FaderOrg/fader25_pcb/README.md

# fader25_pcb
Repository for the Fader2.5 Altium database
