FaderOrg/fader25_pcb/Project Outputs for fader2_pcb/Report Board Stack/fader2_blind_vias_pcb.xls

Board Stack Report
Stack Up |  | Layer Stack
Layer | Board Layer Stack | Name | Material | Thickness | Constant
1 |  | Top Paste
2 |  | Top Overlay
3 |  | Top Solder | Solder Resist | 0.40mil | 3.5
4 |  | TOP | Copper | 1.40mil
5 |  | Dielectric 1 | FR-4 | 10.00mil | 4.2
6 |  | L2 | Copper | 1.42mil
7 |  | Dielectric 8 |  | 5.00mil | 4.2
8 |  | L3 | Copper | 1.42mil
9 |  | Dielectric 6 |  | 10.00mil | 4.2
10 |  | L4 | Copper | 1.42mil
11 |  | Dielectric 7 |  | 5.00mil | 4.2
12 |  | L5 | Copper | 1.42mil
13 |  | Dielectric 2 |  | 10.00mil | 4.2
14 |  | BOT | Copper | 1.40mil
15 |  | Bottom Solder | Solder Resist | 0.40mil | 3.5
16 |  | Bottom Overlay
17 |  | Bottom Paste
 | Height : 49.27mil
