FaderOrg/fader25_pcb/Project Outputs for fader2_pcb/BOM/Bill of Materials-fader2_pcb.xlsx

Comment | Description | Designator | Digikey ID | Footprint | LibRef | Manufacturer | Manufacturer ID | Quantity | Layer
TC1.5-52TG2+ | Balun | BL2 |  | AT224-3 | TC1.5-52TG2+ | Mini-Circuits | TC1.5-52TG2+ | 1 | Top
3.3uF |  | C1, C4, C13, C14, C18, C19, C25, C29, C32, C34, C46, C48, C52, C64, C65, C66, C70, C78, C86, C99, C105, C113, C115 | 445-13819-1-ND | 0402 | cap 3p3uF | TDK | C1005X5R1A335K050BC | 23 | Top, Top, Top, Top, Top, Bottom, Top, Top, Top, Bottom, Top, Bottom, Bottom, Top, Top, Top, Top, Top, Bottom, Bottom, Top, Top, Bottom
1uF |  | C2, C23, C31, C33, C37, C38, C40, C90, C92, C95, C104, C114 | 1276-1447-1-ND | 0402 | cap 1uF 0402 | Samsung Electro-Mechanics | CL05A105MO5NNNC | 12 | Top
100nF |  | C3, C17, C26, C47, C63, C69, C71, C75, C77 | 1276-1001-1-ND | 0402 | cap 100nF | Samsung Electro-Mechanics | CL05B104KO5NNNC | 9 | Top, Bottom, Top, Top, Top, Top, Top, Top, Top
10nF |  | C5, C21, C36, C39, C43, C50, C62, C84, C85, C88, C91, C96, C98, C102, C117 | 490-4762-1-ND | 0402 | cap 10nF | Murata | GCM155R71H103KA55D | 15 | Bottom, Bottom, Bottom, Top, Top, Bottom, Top, Top, Top, Bottom, Top, Top, Bottom, Top, Bottom
100pF |  | C6, C22, C51, C89, C100, C103, C118 | 490-6113-1-ND | 0201 | cap 100pF | Murata | GRM0335C1H101JA01D | 7 | Bottom
22uF |  | C8, C10, C67 | 490-4524-1-ND | 1210 | cap 22uF | Murata | GRM32ER71C226KE18L | 3 | Top
1uF |  | C11, C12 | 490-1543-1-ND | 0603 | cap 1uF 0603 | Murata | GRM188R61A105KA61D | 2 | Top
220nF |  | C20, C30, C35, C49, C53, C87, C116 | 1276-1176-1-ND | 0402 | cap 220nF | Samsung Electro-Mechanics | CL05B224KO5NNNC | 7 | Bottom
680pF |  | C76 | 490-14330-1-ND | 0201 | cap 680pF | Murata | GRM0335C1E681JA01D | 1 | Top
Header_3 |  | EN_DVDD, EN_GATE_LINK, EN_VDD_IO, EN_VDD_LINK, EN_VDDA, H5, H7, H16, H18, H19 | 609-3461-ND | HDR1X3 | Header_3 | FCI | 68000-103HLF | 10 | Top
Ferrite Bead |  | FB1, FB3, FB4, FB5, FB7, FB10 | 732-1592-1-ND | 0603 | Ferrite Bead | Wurth | 742792641 | 6 | Top, Top, Top, Bottom, Top, Top
Header 6X2 | Header, 6-Pin, Dual row | H9 | 609-3237-ND | HDR2X6 | Header 6X2 | Amphenol FCI | 67997-212HLF | 1 | Top
Header_2 |  | H13, H15, H17, H20, H25, H_DVDD, H_GATE_LINK, H_VDD_IO, H_VDD_LINK, H_VDDA | 609-3469-ND | HDR1X2 | Header_2 | FCI | 68001-202HLF | 10 | Top
Header 10X2 | Header, 10-Pin, Dual row | P1 | 609-3239-ND | HDR2X10 | Header 10X2 | Amphenol FCI | 67997-220HLF | 1 | Top
1.5Kohm |  | R1, R72 | P1.5KDBCT-ND | 0603 | res 1.5 Kohm | Panasonic | ERA-3AEB152V | 2 | Top
4.32Kohm |  | R2 | P4.32KDBCT-ND | 0603 | res 4.32 Kohm | Panasonic | ERA-3AEB4321V | 1 | Top
930ohm |  | R3 | 311-2391-1-ND | 0603 | res 930 ohm | Yageo | RT0603DRD07931RL | 1 | Top
0.11ohm |  | R4, R24, R38, R39, R41 | RL16R.11FCT-ND | 1206 | res 0.11 ohm | Susumu | RL1632R-R110-F | 5 | Top
3Kohm |  | R5 | P3.0KDBCT-ND | 0603 | res 3 Kohm | Panasonic | ERA-3AEB302V | 1 | Top
2.67Kohm |  | R6, R40 | P2.67KDBCT-ND | 0603 | res 2.67 Kohm | Panasonic | ERA-3AEB2671V | 2 | Top
3.48Kohm |  | R8 | P3.48KDBCT-ND | 0603 | res 3.5 Kohm | Panasonic | ERA-3AEB3481V | 1 | Top
0ohm |  | R9, R30, R52 | P0.0GCT-ND | 0603 | res 0 ohm 0603 | Panasonic | ERJ-3GEY0R00V | 3 | Top
10kohm |  | R11, R12, R13, R14, R15, R16, R17, R18, R19, R20 | P10KDBCT-ND | 0603 | res 10 Kohm | Panasonic | ERA-3AEB103V | 10 | Top
1kohm |  | R21, R22, R23, R31, R32, R33 | P1.00KHCT-ND | 0603 | res 1 Kohm | Panasonic | ERJ-3EKF1001V | 6 | Top
13Kohm |  | R36 | P13KDBCT-ND | 0603 | res 13 Kohm | Panasonic | ERA-3AEB133V | 1 | Top
50ohm |  | R44 | P49.9ABCT-ND | 0201 | res 50 ohm | Panasonic | ERJ-1GEF49R9C | 1 | Top
20Kohm |  | R46, R47 | P20.0KLCT-ND | 0402 | res 20 Kohm | Panasonic | ERJ-2RKF2002X | 2 | Top
300ohm |  | R73 | P300DBCT-ND | 0603 | res 300 ohm | Panasonic | ERA-3AEB301V | 1 | Top
SMA low freq | Johnson SMA | SMA_ANA_N, SMA_ANA_P | WM5543-ND | THRU_SMA_JOHNSON | SMA_JOHNSON | Molex | 0733910060 | 2 | Top
SMA high freq |  | SMA_ANT_0_N, SMA_ANT_0_P, SMA_ANT_1_N, SMA_ANT_1_P, SMA_ANT_2_N, SMA_ANT_2_P, SMA_ANT_3_N, SMA_ANT_3_P, SMA_LINK_RX_N, SMA_LINK_RX_P, SMA_LINK_TX_N, SMA_LINK_TX_P, SMA_LO_N, SMA_LO_P, SMA_LOAD, SMA_OPEN, SMA_SHORT, SMA_THRU_LINK0, SMA_THRU_LINK1, SMA_THRU_RF0, SMA_THRU_RF1 | ACX1962-ND | THRU_SMD_SMA | SMA_THRU_SMD | Amphenol | 132134-15 | 21 | Top
SMA mid freq | Johnson SMA With Cutout | SMA_DIG_CLK | WM5543-ND | THRU_SMA_JOHNSON_CUTOUT | SMA_JOHNSON_CUTOUT | Molex | 0733910060 | 1 | Top
 |  | TP_ANA_N, TP_ANA_P, TP_DVDD, TP_GATE_LINK, TP_VDD_BUFFER, TP_VDD_IO, TP_VDD_LINK, TP_VDDA |  | Test_Point | Test_Point |  |  | 8 | Top
TPS74201 | Variable Voltage Regulator | U1, U3, U12, U16, U21 | 296-19890-1-ND | TPS74201 | TPS74201 | TI | TPS74201RGWR | 5 | Top
 |  | U2 |  | FADER2 | FADER2 |  |  | 1 | Top
AD5254 | Digital Pot | U2, U22 | AD5254BRUZ1-ND | AD5254 | AD5254 | Analog Devices | AD5254BRUZ1 | 2 | Top
NLSV4T244DTR2G | Logic Translator | U4, U7 | NLSV4T244DTR2GOSCT-ND | 948G-01 | NLSV4T244 | ON Semiconductor | NLSV4T244DTR2G | 2 | Top
PCA9517 | I2C Repeater | U5, U6 | 296-24730-1-ND | PCA9517 | PCA9517 | TI | PCA9517DGKR | 2 | Top
MAX9612 | OpAmp ADC | U8, U9, U10, U32 | MAX9612AUB+-ND | MAX9612 | MAX9612 | Maxim | MAX9612AUB+ | 4 | Top
LTC6417 | Single Channel, Low Noise, High Linearity Differential Buffer / 16-Bit ADC Driver with Fast Clamp, 1600 MHz Typical GBW, 10000 V/us Typical SR, 4.75 to 5.25 V, 20-Pin QFN (UDC20), Commercial, Pb-Free | U19 | LTC6417CUDC#PBF-ND | LT-UDC-20_N | LTC6417CUDC#PBF | Linear Technology | LTC6417CUDC#PBF | 1 | Top
TPS79650 | Single Output High PSRR LDO, 1 A, Fixed 5 V Output, 2.7 to 5.5 V Input, 8-pin SON (DRB), -40 to 125 degC, Green (RoHS & no Sb/Br) | U20 | 296-21352-1-ND | TI-DRB8-2400X1650TP_V | TPS79650DRBR | Texas Instruments | TPS79650DRBR | 1 | Top
