FaderOrg/fader25_pcb/Files_for_TestPlan_TestReports/FADER2_bumps.xlsx

Sheet: Full
 | name
 | type= | NC,POW,GND,analog,digital,open-drain,remove=to be removed
 | direction= | input,output,inout
 | match | string
 | termination | 50,40, CMOS
 | side | the side of the layout where the corresponding io cell will be placed. Only the cells with the sides defined will be placed.Area for the non IO ring cells
 | location | [int,int]
 | cell= | name of the IO library cell used forthis particular io. Bump for bump
 |  |  |  |  |  |  |  |  |  |  |  |  |  |  |  |  |  |  |  |  |  |  |  |  |  | Pad Pitch | 0.17
NC;remove;;;;; | VSS;GND;;;;;;bump | ANT_0_P;analog;inout;;;area;;bump | ANT_0_N;analog;inout;;;area;;bump | VSS;GND;;;;;;bump | VSS;GND;;;;;;bump | LO_OVERRIDE_P;analog;inout;;;bottom;;bump | LO_OVERRIDE_N;analog;inout;;;bottom;;bump | VSS;GND;;;;;;bump | RESET;digital;input;;;top;;DIGITAL_IO_OBFUSCATED | SERDES_SUPPLY_PROBE_0;analog;output;;;;;bump | VSS;GND;;;;;;bump | LINK_BM_TX_0_P;analog;output;;;;;bump | LINK_BM_TX_0_N;analog;output;;;;;bump | VSS;GND;;;;;;bump | LINK_BM_RX_0_P;analog;input;;;;;bump | LINK_BM_RX_0_N;analog;input;;;;;bump | VSS;GND;;;;;;bump | VSS;GND;;;;;;bump | IREF_ANALOG;analog;input;;;;;bump | VSS;GND;;;;;;bump | VSS;GND;;;;;;bump | ANT_1_P;analog;inout;;;area;;bump | ANT_1_N;analog;inout;;;area;;bump | VSS;GND;;;;;;bump | NC;remove;;;;; | Col | 26
VSS;GND;;;;;;bump | NC;remove;;;;; | VDD_IO;POW;;;;;;bump | VDD_IO;POW;;;;;;bump | VDD_IO;POW;;;;;;bump | DVDD;POW;;;;;;bump | DVDD;POW;;;;;;bump | DVDD;POW;;;;;;bump | DVDD;POW;;;;;;bump | VSS;GND;;;;;;bump | VSS;GND;;;;;;bump | VSS;GND;;;;;;bump | VSS;GND;;;;;;bump | VDD_BM0;POW;;;;;;bump | VDD_BM0;POW;;;;;;bump | VSS;GND;;;;;;bump | VSS;GND;;;;;;bump | VSS;GND;;;;;;bump | VSS;GND;;;;;;bump | VSS;GND;;;;;;bump | VSS;GND;;;;;;bump | VDD_IO;POW;;;;;;bump | VDD_IO;POW;;;;;;bump | VDD_IO;POW;;;;;;bump | VDD_IO;POW;;;;;;bump | VSS;GND;;;;;;bump | Row | 26
SCAN_IN;digital;input;;;left;;DIGITAL_IO_OBFUSCATED | VDD_IO;POW;;;;;;bump | VDD_IO;POW;;;;;;bump | VDD_IO;POW;;;;;;bump | VDD_IO;POW;;;;;;bump | DVDD;POW;;;;;;bump | DVDD;POW;;;;;;bump | DVDD;POW;;;;;;bump | DVDD;POW;;;;;;bump | VSS;GND;;;;;;bump | VSS;GND;;;;;;bump | VSS;GND;;;;;;bump | VSS;GND;;;;;;bump | VDD_BM0;POW;;;;;;bump | VDD_BM0;POW;;;;;;bump | VSS;GND;;;;;;bump | VSS;GND;;;;;;bump | VSS;GND;;;;;;bump | VSS;GND;;;;;;bump | VSS;GND;;;;;;bump | VSS;GND;;;;;;bump | VDD_IO;POW;;;;;;bump | VDD_IO;POW;;;;;;bump | VDD_IO;POW;;;;;;bump | VDD_IO;POW;;;;;;bump | VSS;GND;;;;;;bump
SCAN_EN;digital;input;;;left;;DIGITAL_IO_OBFUSCATED | VSS;GND;;;;;;bump | VSS;GND;;;;;;bump | VSS;GND;;;;;;bump | VSS;GND;;;;;;bump | VSS;GND;;;;;;bump | VSS;GND;;;;;;bump | VSS;GND;;;;;;bump | VSS;GND;;;;;;bump | VSS;GND;;;;;;bump | VSS;GND;;;;;;bump | VSS;GND;;;;;;bump | VSS;GND;;;;;;bump | Inductor;remove;;;;;; | Inductor;remove;;;;;; | Inductor;remove;;;;;; | VSS;GND;;;;;;bump | VSS;GND;;;;;;bump | VSS;GND;;;;;;bump | VSS;GND;;;;;;bump | VSS;GND;;;;;;bump | VSS;GND;;;;;;bump | VSS;GND;;;;;;bump | VSS;GND;;;;;;bump | VSS;GND;;;;;;bump | VSS;GND;;;;;;bump | height | 4.59
SCAN_CLK;digital;input;;;left;;DIGITAL_IO_OBFUSCATED | VSS;GND;;;;;;bump | VSS;GND;;;;;;bump | VSS;GND;;;;;;bump | VSS;GND;;;;;;bump | VSS;GND;;;;;;bump | VSS;GND;;;;;;bump | VSS;GND;;;;;;bump | VSS;GND;;;;;;bump | VSS;GND;;;;;;bump | VSS;GND;;;;;;bump | VSS;GND;;;;;;bump | VSS;GND;;;;;;bump | VDD_BM0;POW;;;;;;bump | VDD_BM0;POW;;;;;;bump | VSS;GND;;;;;;bump | VSS;GND;;;;;;bump | VSS;GND;;;;;;bump | VSS;GND;;;;;;bump | VSS;GND;;;;;;bump | VSS;GND;;;;;;bump | VSS;GND;;;;;;bump | VSS;GND;;;;;;bump | VSS;GND;;;;;;bump | VSS;GND;;;;;;bump | VSS;GND;;;;;;bump | width | 4.59
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
REF_LO_P;analog;input;;;;;bump | VDD_IO;POW;;;;;;bump | VDD_IO;POW;;;;;;bump | VDD_IO;POW;;;;;;bump | VDD_IO;POW;;;;;;bump | VSS;GND;;;;;;bump | VSS;GND;;;;;;bump | VSS;GND;;;;;;bump | VSS;GND;;;;;;bump | VSS;GND;;;;;;bump | VSS;GND;;;;;;bump | VSS;GND;;;;;;bump | VSS;GND;;;;;;bump | VSS;GND;;;;;;bump | VDD_BM2;POW;;;;;;bump | VDD_BM2;POW;;;;;;bump | VSS;GND;;;;;;bump | VSS;GND;;;;;;bump | VSS;GND;;;;;;bump | VSS;GND;;;;;;bump | VSS;GND;;;;;;bump | VDD_IO;POW;;;;;;bump | VDD_IO;POW;;;;;;bump | VDD_IO;POW;;;;;;bump | VDD_IO;POW;;;;;;bump | REF_DIG_P;analog;input;;;;;bump
VSS;GND;;;;;;bump | VDD_IO;POW;;;;;;bump | VDD_IO;POW;;;;;;bump | VDD_IO;POW;;;;;;bump | VDD_IO;POW;;;;;;bump | VSS;GND;;;;;;bump | VSS;GND;;;;;;bump | VSS;GND;;;;;;bump | VSS;GND;;;;;;bump | VSS;GND;;;;;;bump | VSS;GND;;;;;;bump | VSS;GND;;;;;;bump | VSS;GND;;;;;;bump | VSS;GND;;;;;;bump | VDD_BM2;POW;;;;;;bump | VDD_BM2;POW;;;;;;bump | VSS;GND;;;;;;bump | VSS;GND;;;;;;bump | VSS;GND;;;;;;bump | VSS;GND;;;;;;bump | VSS;GND;;;;;;bump | VDD_IO;POW;;;;;;bump | VDD_IO;POW;;;;;;bump | VDD_IO;POW;;;;;;bump | VDD_IO;POW;;;;;;bump | VSS;GND;;;;;;bump
NC;remove;;;;; | VSS;GND;;;;;;bump | ANT_3_P;analog;inout;;;area;;bump | ANT_3_N;analog;inout;;;area;;bump | VSS;GND;;;;;;bump | VSS;GND;;;;;;bump | ANA_MUX_P;analog;input;;;bottom;;bump | ANA_MUX_N;analog;input;;;bottom;;bump | VSS;GND;;;;;;bump | VSS;GND;;;;;;bump | SERDES_SUPPLY_PROBE_2;analog;output;;;;;bump | VSS;GND;;;;;;bump | LINK_BM_RX_2_P;analog;input;;;;;bump | LINK_BM_RX_2_N;analog;input;;;;;bump | VSS;GND;;;;;;bump | LINK_BM_TX_2_P;analog;output;;;;;bump | LINK_BM_TX_2_N;analog;output;;;;;bump | VSS;GND;;;;;;bump | VSS;GND;;;;;;bump | CLK_DIG_OVERRIDE_P;analog;input;;;;;bump | CLK_DIG_OVERRIDE_N;analog;input;;;;;bump | VSS;GND;;;;;;bump | ANT_2_P;analog;inout;;;area;;bump | ANT_2_N;analog;inout;;;area;;bump | VSS;GND;;;;;;bump | NC;remove;;;;;
 |  |  |  |  |  |  |  |  |  | VDD;POW;;;;;;bump | VDD;POW;;;;;;bump | VDD;POW;;;;;;bump | VDD;POW;;;;;;bump
 |  |  |  |  |  |  |  |  |  | VDD;POW;;;;;;bump | VDD;POW;;;;;;bump | VDD;POW;;;;;;bump | VDD;POW;;;;;;bump
 |  |  |  |  |  |  |  |  |  | VSS;GND;;;;;;bump | VSS;GND;;;;;;bump | VSS;GND;;;;;;bump | VSS;GND;;;;;;bump
 |  |  |  |  |  |  |  |  |  | VSS;GND;;;;;;bump | VSS;GND;;;;;;bump | VSS;GND;;;;;;bump | VSS;GND;;;;;;bump

Sheet: Visual
 |  |  |  |  |  |  |  |  |  |  |  |  |  |  |  |  |  |  |  |  |  |  |  |  |  | Pad Pitch | 0.17
NC | VSS | ANT_0_P | ANT_0_N | VSS | VSS | LO_OVERRIDE_P | LO_OVERRIDE_N | VSS | RESET | SERDES_SUPPLY_PROBE_0 | VSS | LINK_BM_TX_0_P | LINK_BM_TX_0_N | VSS | LINK_BM_RX_0_P | LINK_BM_RX_0_N | VSS | VSS | IREF_ANALOG | VSS | VSS | ANT_1_P | ANT_1_N | VSS | NC | Col | 26
VSS | NC | VDD_IO | VDD_IO | VDD_IO | DVDD | DVDD | DVDD | DVDD | VSS | VSS | VSS | VSS | VDD_BM0 | VDD_BM0 | VSS | VSS | VSS | VSS | VSS | VSS | VDD_IO | VDD_IO | VDD_IO | VDD_IO | VSS | Row | 26
SCAN_IN | VDD_IO | VDD_IO | VDD_IO | VDD_IO | DVDD | DVDD | DVDD | DVDD | VSS | VSS | VSS | VSS | VDD_BM0 | VDD_BM0 | VSS | VSS | VSS | VSS | VSS | VSS | VDD_IO | VDD_IO | VDD_IO | VDD_IO | VSS
SCAN_EN | VSS | VSS | VSS | VSS | VSS | VSS | VSS | VSS | VSS | VSS | VSS | VSS | Inductor | Inductor | Inductor | VSS | VSS | VSS | VSS | VSS | VSS | VSS | VSS | VSS | VSS | height | 4.59
SCAN_CLK | VSS | VSS | VSS | VSS | VSS | VSS | VSS | VSS | VSS | VSS | VSS | VSS | VDD_BM0 | VDD_BM0 | VSS | VSS | VSS | VSS | VSS | VSS | VSS | VSS | VSS | VSS | VSS | width | 4.59
SCAN_OUT | VSS | VSS | VSS | VSS | VSS | VSS | VSS | VSS | DVDD | DVDD | DVDD | DVDD | VDD_BM0 | VDD_BM0 | VSS | VSS | VSS | VSS | VSS | VSS | VSS | VSS | VSS | VSS | VSS
VSS | VSS | VSS | VSS | VSS | VSS | VSS | VSS | VSS | DVDD | DVDD | DVDD | DVDD | Inductor | Inductor | Inductor | VSS | VSS | VSS | VSS | VSS | VSS | Inductor | Inductor | Inductor | VSS
LINK_BM_RX_3_P | VDD_BM3 | VDD_BM3 | VSS | VSS | VSS | VSS | DVDD | DVDD | DVDD | DVDD | VSS | VSS | VSS | VSS | DVDD | DVDD | DVDD | DVDD | VSS | VSS | VSS | VSS | VDD_BM1 | VDD_BM1 | LINK_BM_TX_1_P | VSS | 373
LINK_BM_RX_3_N | VDD_BM3 | VDD_BM3 | VSS | VSS | VSS | VSS | DVDD | DVDD | DVDD | DVDD | VSS | VSS | VSS | VSS | DVDD | DVDD | DVDD | DVDD | VSS | VSS | VSS | VSS | VDD_BM1 | VDD_BM1 | LINK_BM_TX_1_N | DVDD | 94
VSS | Inductor | Inductor | Inductor | VSS | VSS | VSS | VSS | VSS | VDDA | VDDA | VDDA | VDDA | VSS | VSS | VSS | VSS | VSS | VSS | VSS | VSS | VSS | Inductor | Inductor | Inductor | VSS | VDD_LINK* | 16
LINK_BM_TX_3_P | VDD_BM3 | VDD_BM3 | VSS | VSS | VSS | VSS | VSS | VSS | VDDA | VDDA | VDDA | VDDA | VSS | VSS | VSS | VSS | VSS | VSS | VSS | VSS | VSS | VSS | VDD_BM1 | VDD_BM1 | LINK_BM_RX_1_P | VDD_BM* | 32
LINK_BM_TX_3_N | VDD_BM3 | VDD_BM3 | VSS | VSS | VSS | VSS | VSS | VSS | VSS | VSS | VSS | VSS | VDDA | VDDA | VDDA | VDDA | DVDD | DVDD | DVDD | DVDD | VSS | VSS | VDD_BM1 | VDD_BM1 | LINK_BM_RX_1_N | VDDA | 32
VSS | Inductor | Inductor | Inductor | VSS | VSS | VSS | VSS | VSS | VSS | VSS | VSS | VSS | VDDA | VDDA | VDDA | VDDA | DVDD | DVDD | DVDD | DVDD | VSS | Inductor | Inductor | Inductor | VSS | VDD_IO | 31
LINK_CM_RX_1_P | VDD_LINK_CM1 | VDD_LINK_CM1 | VSS | VSS | DVDD | DVDD | DVDD | DVDD | VDDA | VDDA | VDDA | VDDA | VDDA | VDDA | VDDA | VDDA | VSS | VSS | VSS | VSS | VSS | VSS | VDD_LINK_CM0 | VDD_LINK_CM0 | LINK_CM_TX_0_P
LINK_CM_RX_1_N | VDD_LINK_CM1 | VDD_LINK_CM1 | VSS | VSS | DVDD | DVDD | DVDD | DVDD | VDDA | VDDA | VDDA | VDDA | VDDA | VDDA | VDDA | VDDA | VSS | VSS | VSS | VSS | VSS | VSS | VDD_LINK_CM0 | VDD_LINK_CM0 | LINK_CM_TX_0_N | Inductor | 39
VSS | Inductor | Inductor | Inductor | VSS | VSS | VSS | VSS | VSS | VSS | VSS | VSS | VSS | VSS | VSS | VSS | VSS | DVDD | DVDD | DVDD | DVDD | VSS | Inductor | Inductor | Inductor | VSS | NC | 5
LINK_CM_TX_1_P | VDD_LINK_CM1 | VDD_LINK_CM1 | VSS | VSS | VSS | VSS | VSS | VSS | VSS | VSS | VSS | VSS | VSS | VSS | VSS | VSS | DVDD | DVDD | DVDD | DVDD | VSS | VSS | VDD_LINK_CM0 | VDD_LINK_CM0 | LINK_CM_RX_0_P | used bumps | 632
LINK_CM_TX_1_N | VDD_LINK_CM1 | VDD_LINK_CM1 | VSS | VSS | VSS | VSS | VSS | VSS | DVDD | DVDD | DVDD | DVDD | DVDD | DVDD | DVDD | DVDD | VSS | VSS | VSS | VSS | VSS | VSS | VDD_LINK_CM0 | VDD_LINK_CM0 | LINK_CM_RX_0_N
VSS | Inductor | Inductor | Inductor | VSS | VSS | VSS | VSS | VSS | DVDD | DVDD | DVDD | DVDD | DVDD | DVDD | DVDD | DVDD | VSS | VSS | VSS | VSS | VSS | Inductor | Inductor | Inductor | VSS
REF_SERDES_CM1_P | VSS | VSS | VSS | VSS | VSS | VSS | DVDD | DVDD | DVDD | DVDD | VSS | VSS | Inductor | Inductor | Inductor | DVDD | DVDD | DVDD | VSS | VSS | VSS | VSS | VSS | VSS | REF_SERDES_CM0_P
REF_SERDES_CM1_N | VSS | VSS | VSS | VSS | VSS | VSS | DVDD | DVDD | DVDD | DVDD | VSS | VSS | VSS | VDD_BM2 | VDD_BM2 | DVDD | DVDD | DVDD | VSS | VSS | VSS | VSS | VSS | VSS | REF_SERDES_CM0_N
VSS | DVDD | DVDD | DVDD | DVDD | VSS | VSS | VSS | VSS | VSS | VSS | VSS | VSS | VSS | VDD_BM2 | VDD_BM2 | VSS | VSS | VSS | VSS | VSS | VSS | VSS | VSS | VSS | VSS
REF_LO_N | DVDD | DVDD | DVDD | DVDD | VSS | VSS | VSS | VSS | VSS | VSS | VSS | VSS | Inductor | Inductor | Inductor | VSS | VSS | VSS | VSS | VSS | VSS | VSS | VSS | VSS | REF_DIG_N
REF_LO_P | VDD_IO | VDD_IO | VDD_IO | VDD_IO | VSS | VSS | VSS | VSS | VSS | VSS | VSS | VSS | VSS | VDD_BM2 | VDD_BM2 | VSS | VSS | VSS | VSS | VSS | VDD_IO | VDD_IO | VDD_IO | VDD_IO | REF_DIG_P
VSS | VDD_IO | VDD_IO | VDD_IO | VDD_IO | VSS | VSS | VSS | VSS | VSS | VSS | VSS | VSS | VSS | VDD_BM2 | VDD_BM2 | VSS | VSS | VSS | VSS | VSS | VDD_IO | VDD_IO | VDD_IO | VDD_IO | VSS
NC | VSS | ANT_3_P | ANT_3_N | VSS | VSS | ANA_MUX_P | ANA_MUX_N | VSS | VSS | SERDES_SUPPLY_PROBE_2 | VSS | LINK_BM_RX_2_P | LINK_BM_RX_2_N | VSS | LINK_BM_TX_2_P | LINK_BM_TX_2_N | VSS | VSS | CLK_DIG_OVERRIDE_P | CLK_DIG_OVERRIDE_N | VSS | ANT_2_P | ANT_2_N | VSS | NC

Sheet: BUMP_DOWN
 | This sheet shows the bumps as they lay on PCB in flip-chip assembly. Layout is mirrored relative to Y axis (i.e. flipped left to right)
 |  |  |  |  |  |  | 8
 | AF | AE | AD | AC | AB | AA | Y | W | V | U | T | R | P | N | M | L | K | J | H | G | F | E | D | C | B | A | Pad Pitch | 0.17
1 | NC | VSS | ANT_1_N | ANT_1_P | VSS | VSS | IREF_ANALOG | VSS | VSS | LINK_BM_RX_0_N | LINK_BM_RX_0_P | VSS | LINK_BM_TX_0_N | LINK_BM_TX_0_P | VSS | SERDES_SUPPLY_PROBE_0 | RESET | VSS | LO_OVERRIDE_N | LO_OVERRIDE_P | VSS | VSS | ANT_0_N | ANT_0_P | VSS | NC | Col | 26
2 | VSS | VDD_IO | VDD_IO | VDD_IO | VDD_IO | VSS | VSS | VSS | VSS | VSS | VSS | VDD_BM0 | VDD_BM0 | VSS | VSS | VSS | VSS | DVDD | DVDD | DVDD | DVDD | VDD_IO | VDD_IO | VDD_IO | NC | VSS | Row | 26
3 | VSS | VDD_IO | VDD_IO | VDD_IO | VDD_IO | VSS | VSS | VSS | VSS | VSS | VSS | VDD_BM0 | VDD_BM0 | VSS | VSS | VSS | VSS | DVDD | DVDD | DVDD | DVDD | VDD_IO | VDD_IO | VDD_IO | VDD_IO | SCAN_IN
4 | VSS | VSS | VSS | VSS | VSS | VSS | VSS | VSS | VSS | VSS | Inductor | Inductor | Inductor | VSS | VSS | VSS | VSS | VSS | VSS | VSS | VSS | VSS | VSS | VSS | VSS | SCAN_EN | height | 4.59
5 | VSS | VSS | VSS | VSS | VSS | VSS | VSS | VSS | VSS | VSS | VSS | VDD_BM0 | VDD_BM0 | VSS | VSS | VSS | VSS | VSS | VSS | VSS | VSS | VSS | VSS | VSS | VSS | SCAN_CLK | width | 4.59
6 | VSS | VSS | VSS | VSS | VSS | VSS | VSS | VSS | VSS | VSS | VSS | VDD_BM0 | VDD_BM0 | DVDD | DVDD | DVDD | DVDD | VSS | VSS | VSS | VSS | VSS | VSS | VSS | VSS | SCAN_OUT
7 | VSS | VSS | VSS | VSS | VSS | VSS | VSS | VSS | VSS | VSS | Inductor | Inductor | Inductor | DVDD | DVDD | DVDD | DVDD | VSS | VSS | VSS | VSS | VSS | VSS | VSS | VSS | VSS
8 | LINK_BM_TX_1_P | VDD_BM1 | VDD_BM1 | VSS | VSS | VSS | VSS | DVDD | DVDD | DVDD | DVDD | VSS | VSS | VSS | VSS | DVDD | DVDD | DVDD | DVDD | VSS | VSS | VSS | VSS | VDD_BM3 | VDD_BM3 | LINK_BM_RX_3_P | VSS | 376
9 | LINK_BM_TX_1_N | VDD_BM1 | VDD_BM1 | VSS | VSS | VSS | VSS | DVDD | DVDD | DVDD | DVDD | VSS | VSS | VSS | VSS | DVDD | DVDD | DVDD | DVDD | VSS | VSS | VSS | VSS | VDD_BM3 | VDD_BM3 | LINK_BM_RX_3_N | DVDD | 94
10 | VSS | Inductor | Inductor | Inductor | VSS | VSS | VSS | VSS | VSS | VSS | VSS | VSS | VSS | VDDA | VDDA | VDDA | VDDA | VSS | VSS | VSS | VSS | VSS | Inductor | Inductor | Inductor | VSS | VDD_LINK* | 16
11 | LINK_BM_RX_1_P | VDD_BM1 | VDD_BM1 | VSS | VSS | VSS | VSS | VSS | VSS | VSS | VSS | VSS | VSS | VDDA | VDDA | VDDA | VDDA | VSS | VSS | VSS | VSS | VSS | VSS | VDD_BM3 | VDD_BM3 | LINK_BM_TX_3_P | VDD_BM* | 32
12 | LINK_BM_RX_1_N | VDD_BM1 | VDD_BM1 | VSS | VSS | DVDD | DVDD | DVDD | DVDD | VDDA | VDDA | VDDA | VDDA | VSS | VSS | VSS | VSS | VSS | VSS | VSS | VSS | VSS | VSS | VDD_BM3 | VDD_BM3 | LINK_BM_TX_3_N | VDDA | 32
13 | VSS | Inductor | Inductor | Inductor | VSS | DVDD | DVDD | DVDD | DVDD | VDDA | VDDA | VDDA | VDDA | VSS | VSS | VSS | VSS | VSS | VSS | VSS | VSS | VSS | Inductor | Inductor | Inductor | VSS | VDD_IO | 31
14 | LINK_CM_TX_0_P | VDD_LINK_CM0 | VDD_LINK_CM0 | VSS | VSS | VSS | VSS | VSS | VSS | VDDA | VDDA | VDDA | VDDA | VDDA | VDDA | VDDA | VDDA | DVDD | DVDD | DVDD | DVDD | VSS | VSS | VDD_LINK_CM1 | VDD_LINK_CM1 | LINK_CM_RX_1_P
15 | LINK_CM_TX_0_N | VDD_LINK_CM0 | VDD_LINK_CM0 | VSS | VSS | VSS | VSS | VSS | VSS | VDDA | VDDA | VDDA | VDDA | VDDA | VDDA | VDDA | VDDA | DVDD | DVDD | DVDD | DVDD | VSS | VSS | VDD_LINK_CM1 | VDD_LINK_CM1 | LINK_CM_RX_1_N | Inductor | 36
16 | VSS | Inductor | Inductor | Inductor | VSS | DVDD | DVDD | DVDD | DVDD | VSS | VSS | VSS | VSS | VSS | VSS | VSS | VSS | VSS | VSS | VSS | VSS | VSS | Inductor | Inductor | Inductor | VSS | NC | 5
17 | LINK_CM_RX_0_P | VDD_LINK_CM0 | VDD_LINK_CM0 | VSS | VSS | DVDD | DVDD | DVDD | DVDD | VSS | VSS | VSS | VSS | VSS | VSS | VSS | VSS | VSS | VSS | VSS | VSS | VSS | VSS | VDD_LINK_CM1 | VDD_LINK_CM1 | LINK_CM_TX_1_P | used bumps | 635
18 | LINK_CM_RX_0_N | VDD_LINK_CM0 | VDD_LINK_CM0 | VSS | VSS | VSS | VSS | VSS | VSS | DVDD | DVDD | DVDD | DVDD | DVDD | DVDD | DVDD | DVDD | VSS | VSS | VSS | VSS | VSS | VSS | VDD_LINK_CM1 | VDD_LINK_CM1 | LINK_CM_TX_1_N
19 | VSS | Inductor | Inductor | Inductor | VSS | VSS | VSS | VSS | VSS | DVDD | DVDD | DVDD | DVDD | DVDD | DVDD | DVDD | DVDD | VSS | VSS | VSS | VSS | VSS | Inductor | Inductor | Inductor | VSS
20 | REF_SERDES_CM0_P | VSS | VSS | VSS | VSS | VSS | VSS | DVDD | DVDD | DVDD | Inductor | Inductor | Inductor | VSS | VSS | DVDD | DVDD | DVDD | DVDD | VSS | VSS | VSS | VSS | VSS | VSS | REF_SERDES_CM1_P
21 | REF_SERDES_CM0_N | VSS | VSS | VSS | VSS | VSS | VSS | DVDD | DVDD | DVDD | VDD_BM2 | VDD_BM2 | VSS | VSS | VSS | DVDD | DVDD | DVDD | DVDD | VSS | VSS | VSS | VSS | VSS | VSS | REF_SERDES_CM1_N
22 | VSS | VSS | VSS | VSS | VSS | VSS | VSS | VSS | VSS | VSS | VDD_BM2 | VDD_BM2 | VSS | VSS | VSS | VSS | VSS | VSS | VSS | VSS | VSS | DVDD | DVDD | DVDD | DVDD | VSS
23 | REF_DIG_N | VSS | VSS | VSS | VSS | VSS | VSS | VSS | VSS | VSS | Inductor | Inductor | Inductor | VSS | VSS | VSS | VSS | VSS | VSS | VSS | VSS | DVDD | DVDD | DVDD | DVDD | REF_LO_N
24 | REF_DIG_P | VDD_IO | VDD_IO | VDD_IO | VDD_IO | VSS | VSS | VSS | VSS | VSS | VDD_BM2 | VDD_BM2 | VSS | VSS | VSS | VSS | VSS | VSS | VSS | VSS | VSS | VDD_IO | VDD_IO | VDD_IO | VDD_IO | REF_LO_P
25 | VSS | VDD_IO | VDD_IO | VDD_IO | VDD_IO | VSS | VSS | VSS | VSS | VSS | VDD_BM2 | VDD_BM2 | VSS | VSS | VSS | VSS | VSS | VSS | VSS | VSS | VSS | VDD_IO | VDD_IO | VDD_IO | VDD_IO | VSS
26 | NC | VSS | ANT_2_N | ANT_2_P | VSS | CLK_DIG_OVERRIDE_N | CLK_DIG_OVERRIDE_P | VSS | VSS | LINK_BM_TX_2_N | LINK_BM_TX_2_P | VSS | LINK_BM_RX_2_N | LINK_BM_RX_2_P | VSS | SERDES_SUPPLY_PROBE_2 | VSS | VSS | ANA_MUX_N | ANA_MUX_P | VSS | VSS | ANT_3_N | ANT_3_P | VSS | NC

Sheet: Bare_for_export
NC;remove;;;;; | VSS;GND;;;;;;bump | ANT_0_P;analog;inout;;;area;;bump | ANT_0_N;analog;inout;;;area;;bump | VSS;GND;;;;;;bump | VSS;GND;;;;;;bump | LO_OVERRIDE_P;analog;inout;;;bottom;;bump | LO_OVERRIDE_N;analog;inout;;;bottom;;bump | VSS;GND;;;;;;bump | RESET;digital;input;;;top;;DIGITAL_IO_OBFUSCATED | SERDES_SUPPLY_PROBE_0;analog;output;;;;;bump | VSS;GND;;;;;;bump | LINK_BM_TX_0_P;analog;output;;;;;bump | LINK_BM_TX_0_N;analog;output;;;;;bump | VSS;GND;;;;;;bump | LINK_BM_RX_0_P;analog;input;;;;;bump | LINK_BM_RX_0_N;analog;input;;;;;bump | VSS;GND;;;;;;bump | VSS;GND;;;;;;bump | IREF_ANALOG;analog;input;;;;;bump | VSS;GND;;;;;;bump | VSS;GND;;;;;;bump | ANT_1_P;analog;inout;;;area;;bump | ANT_1_N;analog;inout;;;area;;bump | VSS;GND;;;;;;bump | NC;remove;;;;;
VSS;GND;;;;;;bump | NC;remove;;;;; | VDD_IO;POW;;;;;;bump | VDD_IO;POW;;;;;;bump | VDD_IO;POW;;;;;;bump | DVDD;POW;;;;;;bump | DVDD;POW;;;;;;bump | DVDD;POW;;;;;;bump | DVDD;POW;;;;;;bump | VSS;GND;;;;;;bump | VSS;GND;;;;;;bump | VSS;GND;;;;;;bump | VSS;GND;;;;;;bump | VDD_BM0;POW;;;;;;bump | VDD_BM0;POW;;;;;;bump | VSS;GND;;;;;;bump | VSS;GND;;;;;;bump | VSS;GND;;;;;;bump | VSS;GND;;;;;;bump | VSS;GND;;;;;;bump | VSS;GND;;;;;;bump | VDD_IO;POW;;;;;;bump | VDD_IO;POW;;;;;;bump | VDD_IO;POW;;;;;;bump | VDD_IO;POW;;;;;;bump | VSS;GND;;;;;;bump
SCAN_IN;digital;input;;;left;;DIGITAL_IO_OBFUSCATED | VDD_IO;POW;;;;;;bump | VDD_IO;POW;;;;;;bump | VDD_IO;POW;;;;;;bump | VDD_IO;POW;;;;;;bump | DVDD;POW;;;;;;bump | DVDD;POW;;;;;;bump | DVDD;POW;;;;;;bump | DVDD;POW;;;;;;bump | VSS;GND;;;;;;bump | VSS;GND;;;;;;bump | VSS;GND;;;;;;bump | VSS;GND;;;;;;bump | VDD_BM0;POW;;;;;;bump | VDD_BM0;POW;;;;;;bump | VSS;GND;;;;;;bump | VSS;GND;;;;;;bump | VSS;GND;;;;;;bump | VSS;GND;;;;;;bump | VSS;GND;;;;;;bump | VSS;GND;;;;;;bump | VDD_IO;POW;;;;;;bump | VDD_IO;POW;;;;;;bump | VDD_IO;POW;;;;;;bump | VDD_IO;POW;;;;;;bump | VSS;GND;;;;;;bump
SCAN_EN;digital;input;;;left;;DIGITAL_IO_OBFUSCATED | VSS;GND;;;;;;bump | VSS;GND;;;;;;bump | VSS;GND;;;;;;bump | VSS;GND;;;;;;bump | VSS;GND;;;;;;bump | VSS;GND;;;;;;bump | VSS;GND;;;;;;bump | VSS;GND;;;;;;bump | VSS;GND;;;;;;bump | VSS;GND;;;;;;bump | VSS;GND;;;;;;bump | VSS;GND;;;;;;bump | Inductor;remove;;;;;; | Inductor;remove;;;;;; | Inductor;remove;;;;;; | VSS;GND;;;;;;bump | VSS;GND;;;;;;bump | VSS;GND;;;;;;bump | VSS;GND;;;;;;bump | VSS;GND;;;;;;bump | VSS;GND;;;;;;bump | VSS;GND;;;;;;bump | VSS;GND;;;;;;bump | VSS;GND;;;;;;bump | VSS;GND;;;;;;bump
SCAN_CLK;digital;input;;;left;;DIGITAL_IO_OBFUSCATED | VSS;GND;;;;;;bump | VSS;GND;;;;;;bump | VSS;GND;;;;;;bump | VSS;GND;;;;;;bump | VSS;GND;;;;;;bump | VSS;GND;;;;;;bump | VSS;GND;;;;;;bump | VSS;GND;;;;;;bump | VSS;GND;;;;;;bump | VSS;GND;;;;;;bump | VSS;GND;;;;;;bump | VSS;GND;;;;;;bump | VDD_BM0;POW;;;;;;bump | VDD_BM0;POW;;;;;;bump | VSS;GND;;;;;;bump | VSS;GND;;;;;;bump | VSS;GND;;;;;;bump | VSS;GND;;;;;;bump | VSS;GND;;;;;;bump | VSS;GND;;;;;;bump | VSS;GND;;;;;;bump | VSS;GND;;;;;;bump | VSS;GND;;;;;;bump | VSS;GND;;;;;;bump | VSS;GND;;;;;;bump
SCAN_OUT;digital;output;;;left;;DIGITAL_IO_OBFUSCATED | VSS;GND;;;;;;bump | VSS;GND;;;;;;bump | VSS;GND;;;;;;bump | VSS;GND;;;;;;bump | VSS;GND;;;;;;bump | VSS;GND;;;;;;bump | VSS;GND;;;;;;bump | VSS;GND;;;;;;bump | DVDD;POW;;;;;;bump | DVDD;POW;;;;;;bump | DVDD;POW;;;;;;bump | DVDD;POW;;;;;;bump | VDD_BM0;POW;;;;;;bump | VDD_BM0;POW;;;;;;bump | VSS;GND;;;;;;bump | VSS;GND;;;;;;bump | VSS;GND;;;;;;bump | VSS;GND;;;;;;bump | VSS;GND;;;;;;bump | VSS;GND;;;;;;bump | VSS;GND;;;;;;bump | VSS;GND;;;;;;bump | VSS;GND;;;;;;bump | VSS;GND;;;;;;bump | VSS;GND;;;;;;bump
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
VSS;GND;;;;;;bump | VDD_IO;POW;;;;;;bump | VDD_IO;POW;;;;;;bump | VDD_IO;POW;;;;;;bump | VDD_IO;POW;;;;;;bump | VSS;GND;;;;;;bump | VSS;GND;;;;;;bump | VSS;GND;;;;;;bump | VSS;GND;;;;;;bump | VSS;GND;;;;;;bump | VSS;GND;;;;;;bump | VSS;GND;;;;;;bump | VSS;GND;;;;;;bump | VSS;GND;;;;;;bump | VDD_BM2;POW;;;;;;bump | VDD_BM2;POW;;;;;;bump | VSS;GND;;;;;;bump | VSS;GND;;;;;;bump | VSS;GND;;;;;;bump | VSS;GND;;;;;;bump | VSS;GND;;;;;;bump | VDD_IO;POW;;;;;;bump | VDD_IO;POW;;;;;;bump | VDD_IO;POW;;;;;;bump | VDD_IO;POW;;;;;;bump | VSS;GND;;;;;;bump
NC;remove;;;;; | VSS;GND;;;;;;bump | ANT_3_P;analog;inout;;;area;;bump | ANT_3_N;analog;inout;;;area;;bump | VSS;GND;;;;;;bump | VSS;GND;;;;;;bump | ANA_MUX_P;analog;input;;;bottom;;bump | ANA_MUX_N;analog;input;;;bottom;;bump | VSS;GND;;;;;;bump | VSS;GND;;;;;;bump | SERDES_SUPPLY_PROBE_2;analog;output;;;;;bump | VSS;GND;;;;;;bump | LINK_BM_RX_2_P;analog;input;;;;;bump | LINK_BM_RX_2_N;analog;input;;;;;bump | VSS;GND;;;;;;bump | LINK_BM_TX_2_P;analog;output;;;;;bump | LINK_BM_TX_2_N;analog;output;;;;;bump | VSS;GND;;;;;;bump | VSS;GND;;;;;;bump | CLK_DIG_OVERRIDE_P;analog;input;;;;;bump | CLK_DIG_OVERRIDE_N;analog;input;;;;;bump | VSS;GND;;;;;;bump | ANT_2_P;analog;inout;;;area;;bump | ANT_2_N;analog;inout;;;area;;bump | VSS;GND;;;;;;bump | NC;remove;;;;;

Sheet: BUMP_DOWN_check
 | This sheet shows the bumps as they lay on PCB in flip-chip assembly. Layout is mirrored relative to Y axis (i.e. flipped left to right)
 |  |  |  |  |  |  | 8
 | AF | AE | AD | AC | AB | AA | Y | W | V | U | T | R | P | N | M | L | K | J | H | G | F | E | D | C | B | A | Pad Pitch | 0.17
1 | NC | VSS | ANT_1_N | ANT_1_P | VSS | VSS | IREF_ANALOG | VSS | VSS | LINK_BM_RX_0_N | LINK_BM_RX_0_P | VSS | LINK_BM_TX_0_N | LINK_BM_TX_0_P | VSS | SERDES_SUPPLY_PROBE_0 | RESET | VSS | LO_OVERRIDE_N | LO_OVERRIDE_P | VSS | VSS | ANT_0_N | ANT_0_P | VSS | NC | Col | 26
2 | VSS | VDD_IO | VDD_IO | VDD_IO | VDD_IO | VSS | VSS | VSS | VSS | VSS | VSS | VDD_BM0 | VDD_BM0 | VSS | VSS | VSS | VSS | DVDD | DVDD | DVDD | DVDD | VDD_IO | VDD_IO | VDD_IO | NC | VSS | Row | 26
3 | VSS | VDD_IO | VDD_IO | VDD_IO | VDD_IO | VSS | VSS | VSS | VSS | VSS | VSS | VDD_BM0 | VDD_BM0 | VSS | VSS | VSS | VSS | DVDD | DVDD | DVDD | DVDD | VDD_IO | VDD_IO | VDD_IO | VDD_IO | SCAN_IN
4 | VSS | VSS | VSS | VSS | VSS | VSS | VSS | VSS | VSS | VSS | Inductor | Inductor | Inductor | VSS | VSS | VSS | VSS | VSS | VSS | VSS | VSS | VSS | VSS | VSS | VSS | SCAN_EN | height | 4.59
5 | VSS | VSS | VSS | VSS | VSS | VSS | VSS | VSS | VSS | VSS | VSS | VDD_BM0 | VDD_BM0 | VSS | VSS | VSS | VSS | VSS | VSS | VSS | VSS | VSS | VSS | VSS | VSS | SCAN_CLK | width | 4.59
6 | VSS | VSS | VSS | VSS | VSS | VSS | VSS | VSS | VSS | VSS | VSS | VDD_BM0 | VDD_BM0 | DVDD | DVDD | DVDD | DVDD | VSS | VSS | VSS | VSS | VSS | VSS | VSS | VSS | SCAN_OUT
7 | VSS | VSS | VSS | VSS | VSS | VSS | VSS | VSS | VSS | VSS | Inductor | Inductor | Inductor | DVDD | DVDD | DVDD | DVDD | VSS | VSS | VSS | VSS | VSS | VSS | VSS | VSS | VSS
8 | LINK_BM_TX_1_P | VDD_BM1 | VDD_BM1 | VSS | VSS | VSS | VSS | DVDD | DVDD | DVDD | DVDD | VSS | VSS | VSS | VSS | DVDD | DVDD | DVDD | DVDD | VSS | VSS | VSS | VSS | VDD_BM3 | VDD_BM3 | LINK_BM_RX_3_P | VSS | 376
9 | LINK_BM_TX_1_N | VDD_BM1 | VDD_BM1 | VSS | VSS | VSS | VSS | DVDD | DVDD | DVDD | DVDD | VSS | VSS | VSS | VSS | DVDD | DVDD | DVDD | DVDD | VSS | VSS | VSS | VSS | VDD_BM3 | VDD_BM3 | LINK_BM_RX_3_N | DVDD | 94
10 | VSS | Inductor | Inductor | Inductor | VSS | VSS | VSS | VSS | VSS | VSS | VSS | VSS | VSS | VDDA | VDDA | VDDA | VDDA | VSS | VSS | VSS | VSS | VSS | Inductor | Inductor | Inductor | VSS | VDD_LINK* | 16
11 | LINK_BM_RX_1_P | VDD_BM1 | VDD_BM1 | VSS | VSS | VSS | VSS | VSS | VSS | VSS | VSS | VSS | VSS | VDDA | VDDA | VDDA | VDDA | VSS | VSS | VSS | VSS | VSS | VSS | VDD_BM3 | VDD_BM3 | LINK_BM_TX_3_P | VDD_BM* | 32
12 | LINK_BM_RX_1_N | VDD_BM1 | VDD_BM1 | VSS | VSS | DVDD | DVDD | DVDD | DVDD | VDDA | VDDA | VDDA | VDDA | VSS | VSS | VSS | VSS | VSS | VSS | VSS | VSS | VSS | VSS | VDD_BM3 | VDD_BM3 | LINK_BM_TX_3_N | VDDA | 32
13 | VSS | Inductor | Inductor | Inductor | VSS | DVDD | DVDD | DVDD | DVDD | VDDA | VDDA | VDDA | VDDA | VSS | VSS | VSS | VSS | VSS | VSS | VSS | VSS | VSS | Inductor | Inductor | Inductor | VSS | VDD_IO | 31
14 | LINK_CM_TX_0_P | VDD_LINK_CM0 | VDD_LINK_CM0 | VSS | VSS | VSS | VSS | VSS | VSS | VDDA | VDDA | VDDA | VDDA | VDDA | VDDA | VDDA | VDDA | DVDD | DVDD | DVDD | DVDD | VSS | VSS | VDD_LINK_CM1 | VDD_LINK_CM1 | LINK_CM_RX_1_P
15 | LINK_CM_TX_0_N | VDD_LINK_CM0 | VDD_LINK_CM0 | VSS | VSS | VSS | VSS | VSS | VSS | VDDA | VDDA | VDDA | VDDA | VDDA | VDDA | VDDA | VDDA | DVDD | DVDD | DVDD | DVDD | VSS | VSS | VDD_LINK_CM1 | VDD_LINK_CM1 | LINK_CM_RX_1_N | Inductor | 36
16 | VSS | Inductor | Inductor | Inductor | VSS | DVDD | DVDD | DVDD | DVDD | VSS | VSS | VSS | VSS | VSS | VSS | VSS | VSS | VSS | VSS | VSS | VSS | VSS | Inductor | Inductor | Inductor | VSS | NC | 5
17 | LINK_CM_RX_0_P | VDD_LINK_CM0 | VDD_LINK_CM0 | VSS | VSS | DVDD | DVDD | DVDD | DVDD | VSS | VSS | VSS | VSS | VSS | VSS | VSS | VSS | VSS | VSS | VSS | VSS | VSS | VSS | VDD_LINK_CM1 | VDD_LINK_CM1 | LINK_CM_TX_1_P | used bumps | 635
18 | LINK_CM_RX_0_N | VDD_LINK_CM0 | VDD_LINK_CM0 | VSS | VSS | VSS | VSS | VSS | VSS | DVDD | DVDD | DVDD | DVDD | DVDD | DVDD | DVDD | DVDD | VSS | VSS | VSS | VSS | VSS | VSS | VDD_LINK_CM1 | VDD_LINK_CM1 | LINK_CM_TX_1_N
19 | VSS | Inductor | Inductor | Inductor | VSS | VSS | VSS | VSS | VSS | DVDD | DVDD | DVDD | DVDD | DVDD | DVDD | DVDD | DVDD | VSS | VSS | VSS | VSS | VSS | Inductor | Inductor | Inductor | VSS
20 | REF_SERDES_CM0_P | VSS | VSS | VSS | VSS | VSS | VSS | DVDD | DVDD | DVDD | Inductor | Inductor | Inductor | VSS | VSS | DVDD | DVDD | DVDD | DVDD | VSS | VSS | VSS | VSS | VSS | VSS | REF_SERDES_CM1_P
21 | REF_SERDES_CM0_N | VSS | VSS | VSS | VSS | VSS | VSS | DVDD | DVDD | DVDD | VDD_BM2 | VDD_BM2 | VSS | VSS | VSS | DVDD | DVDD | DVDD | DVDD | VSS | VSS | VSS | VSS | VSS | VSS | REF_SERDES_CM1_N
22 | VSS | VSS | VSS | VSS | VSS | VSS | VSS | VSS | VSS | VSS | VDD_BM2 | VDD_BM2 | VSS | VSS | VSS | VSS | VSS | VSS | VSS | VSS | VSS | DVDD | DVDD | DVDD | DVDD | VSS
23 | REF_DIG_N | VSS | VSS | VSS | VSS | VSS | VSS | VSS | VSS | VSS | Inductor | Inductor | Inductor | VSS | VSS | VSS | VSS | VSS | VSS | VSS | VSS | DVDD | DVDD | DVDD | DVDD | REF_LO_N
24 | REF_DIG_P | VDD_IO | VDD_IO | VDD_IO | VDD_IO | VSS | VSS | VSS | VSS | VSS | VDD_BM2 | VDD_BM2 | VSS | VSS | VSS | VSS | VSS | VSS | VSS | VSS | VSS | VDD_IO | VDD_IO | VDD_IO | VDD_IO | REF_LO_P
25 | VSS | VDD_IO | VDD_IO | VDD_IO | VDD_IO | VSS | VSS | VSS | VSS | VSS | VDD_BM2 | VDD_BM2 | VSS | VSS | VSS | VSS | VSS | VSS | VSS | VSS | VSS | VDD_IO | VDD_IO | VDD_IO | VDD_IO | VSS
26 | NC | VSS | ANT_2_N | ANT_2_P | VSS | CLK_DIG_OVERRIDE_N | CLK_DIG_OVERRIDE_P | VSS | VSS | LINK_BM_TX_2_N | LINK_BM_TX_2_P | VSS | LINK_BM_RX_2_N | LINK_BM_RX_2_P | VSS | SERDES_SUPPLY_PROBE_2 | VSS | VSS | ANA_MUX_N | ANA_MUX_P | VSS | VSS | ANT_3_N | ANT_3_P | VSS | NC

Sheet: BumpNets
 | This sheet shows the bumps as they lay on PCB in flip-chip assembly. Layout is mirrored relative to Y axis (i.e. flipped left to right)
 |  |  |  |  |  |  | 8
 | AF | AE | AD | AC | AB | AA | Y | W | V | U | T | R | P | N | M | L | K | J | H | G | F | E | D | C | B | A | Pad Pitch | 0.17
1 | NC | VSS | ANT_1_N | ANT_1_P | VSS | VSS | IREF_ANALOG | VSS | VSS | LINK_BM_RX_0_N | LINK_BM_RX_0_P | VSS | LINK_BM_TX_0_N | LINK_BM_TX_0_P | VSS | SERDES_SUPPLY_PROBE_0 | RESET | VSS | LO_OVERRIDE_N | LO_OVERRIDE_P | VSS | VSS | ANT_0_N | ANT_0_P | VSS | NC | Col | 26
2 | VSS | VDD_IO | VDD_IO | VDD_IO | VDD_IO | VSS | VSS | VSS | VSS | VSS | VSS | VDD_BM0 | VDD_BM0 | VSS | VSS | VSS | VSS | DVDD | DVDD | DVDD | DVDD | VDD_IO | VDD_IO | VDD_IO | NC | VSS | Row | 26
3 | VSS | VDD_IO | VDD_IO | VDD_IO | VDD_IO | VSS | VSS | VSS | VSS | VSS | VSS | VDD_BM0 | VDD_BM0 | VSS | VSS | VSS | VSS | DVDD | DVDD | DVDD | DVDD | VDD_IO | VDD_IO | VDD_IO | VDD_IO | SCAN_IN
4 | VSS | VSS | VSS | VSS | VSS | VSS | VSS | VSS | VSS | VSS | Inductor | Inductor | Inductor | VSS | VSS | VSS | VSS | VSS | VSS | VSS | VSS | VSS | VSS | VSS | VSS | SCAN_EN | height | 4.59
5 | VSS | VSS | VSS | VSS | VSS | VSS | VSS | VSS | VSS | VSS | VSS | VDD_BM0 | VDD_BM0 | VSS | VSS | VSS | VSS | VSS | VSS | VSS | VSS | VSS | VSS | VSS | VSS | SCAN_CLK | width | 4.59
6 | VSS | VSS | VSS | VSS | VSS | VSS | VSS | VSS | VSS | VSS | VSS | VDD_BM0 | VDD_BM0 | DVDD | DVDD | DVDD | DVDD | VSS | VSS | VSS | VSS | VSS | VSS | VSS | VSS | SCAN_OUT
7 | VSS | VSS | VSS | VSS | VSS | VSS | VSS | VSS | VSS | VSS | Inductor | Inductor | Inductor | DVDD | DVDD | DVDD | DVDD | VSS | VSS | VSS | VSS | VSS | VSS | VSS | VSS | VSS
8 | LINK_BM_TX_1_P | VDD_BM1 | VDD_BM1 | VSS | VSS | VSS | VSS | DVDD | DVDD | DVDD | DVDD | VSS | VSS | VSS | VSS | DVDD | DVDD | DVDD | DVDD | VSS | VSS | VSS | VSS | VDD_BM3 | VDD_BM3 | LINK_BM_RX_3_P | VSS | 376
9 | LINK_BM_TX_1_N | VDD_BM1 | VDD_BM1 | VSS | VSS | VSS | VSS | DVDD | DVDD | DVDD | DVDD | VSS | VSS | VSS | VSS | DVDD | DVDD | DVDD | DVDD | VSS | VSS | VSS | VSS | VDD_BM3 | VDD_BM3 | LINK_BM_RX_3_N | DVDD | 94
10 | VSS | Inductor | Inductor | Inductor | VSS | VSS | VSS | VSS | VSS | VSS | VSS | VSS | VSS | VDDA | VDDA | VDDA | VDDA | VSS | VSS | VSS | VSS | VSS | Inductor | Inductor | Inductor | VSS | VDD_LINK* | 16 | VDD_LINK_CM0 | 8 | VDD_LINK_CM1 | 8
11 | LINK_BM_RX_1_P | VDD_BM1 | VDD_BM1 | VSS | VSS | VSS | VSS | VSS | VSS | VSS | VSS | VSS | VSS | VDDA | VDDA | VDDA | VDDA | VSS | VSS | VSS | VSS | VSS | VSS | VDD_BM3 | VDD_BM3 | LINK_BM_TX_3_P | VDD_BM* | 32 | VDD_BM0 | 8 | VDD_BM1 | 8 | VDD_BM2 | 8 | VDD_BM3 | 8
12 | LINK_BM_RX_1_N | VDD_BM1 | VDD_BM1 | VSS | VSS | DVDD | DVDD | DVDD | DVDD | VDDA | VDDA | VDDA | VDDA | VSS | VSS | VSS | VSS | VSS | VSS | VSS | VSS | VSS | VSS | VDD_BM3 | VDD_BM3 | LINK_BM_TX_3_N | VDDA | 32
13 | VSS | Inductor | Inductor | Inductor | VSS | DVDD | DVDD | DVDD | DVDD | VDDA | VDDA | VDDA | VDDA | VSS | VSS | VSS | VSS | VSS | VSS | VSS | VSS | VSS | Inductor | Inductor | Inductor | VSS | VDD_IO | 31
14 | LINK_CM_TX_0_P | VDD_LINK_CM0 | VDD_LINK_CM0 | VSS | VSS | VSS | VSS | VSS | VSS | VDDA | VDDA | VDDA | VDDA | VDDA | VDDA | VDDA | VDDA | DVDD | DVDD | DVDD | DVDD | VSS | VSS | VDD_LINK_CM1 | VDD_LINK_CM1 | LINK_CM_RX_1_P
15 | LINK_CM_TX_0_N | VDD_LINK_CM0 | VDD_LINK_CM0 | VSS | VSS | VSS | VSS | VSS | VSS | VDDA | VDDA | VDDA | VDDA | VDDA | VDDA | VDDA | VDDA | DVDD | DVDD | DVDD | DVDD | VSS | VSS | VDD_LINK_CM1 | VDD_LINK_CM1 | LINK_CM_RX_1_N | Inductor | 36
16 | VSS | Inductor | Inductor | Inductor | VSS | DVDD | DVDD | DVDD | DVDD | VSS | VSS | VSS | VSS | VSS | VSS | VSS | VSS | VSS | VSS | VSS | VSS | VSS | Inductor | Inductor | Inductor | VSS | NC | 5
17 | LINK_CM_RX_0_P | VDD_LINK_CM0 | VDD_LINK_CM0 | VSS | VSS | DVDD | DVDD | DVDD | DVDD | VSS | VSS | VSS | VSS | VSS | VSS | VSS | VSS | VSS | VSS | VSS | VSS | VSS | VSS | VDD_LINK_CM1 | VDD_LINK_CM1 | LINK_CM_TX_1_P | used bumps | 635
18 | LINK_CM_RX_0_N | VDD_LINK_CM0 | VDD_LINK_CM0 | VSS | VSS | VSS | VSS | VSS | VSS | DVDD | DVDD | DVDD | DVDD | DVDD | DVDD | DVDD | DVDD | VSS | VSS | VSS | VSS | VSS | VSS | VDD_LINK_CM1 | VDD_LINK_CM1 | LINK_CM_TX_1_N
19 | VSS | Inductor | Inductor | Inductor | VSS | VSS | VSS | VSS | VSS | DVDD | DVDD | DVDD | DVDD | DVDD | DVDD | DVDD | DVDD | VSS | VSS | VSS | VSS | VSS | Inductor | Inductor | Inductor | VSS
20 | REF_SERDES_CM0_P | VSS | VSS | VSS | VSS | VSS | VSS | DVDD | DVDD | DVDD | Inductor | Inductor | Inductor | VSS | VSS | DVDD | DVDD | DVDD | DVDD | VSS | VSS | VSS | VSS | VSS | VSS | REF_SERDES_CM1_P
21 | REF_SERDES_CM0_N | VSS | VSS | VSS | VSS | VSS | VSS | DVDD | DVDD | DVDD | VDD_BM2 | VDD_BM2 | VSS | VSS | VSS | DVDD | DVDD | DVDD | DVDD | VSS | VSS | VSS | VSS | VSS | VSS | REF_SERDES_CM1_N
22 | VSS | VSS | VSS | VSS | VSS | VSS | VSS | VSS | VSS | VSS | VDD_BM2 | VDD_BM2 | VSS | VSS | VSS | VSS | VSS | VSS | VSS | VSS | VSS | DVDD | DVDD | DVDD | DVDD | VSS
23 | REF_DIG_N | VSS | VSS | VSS | VSS | VSS | VSS | VSS | VSS | VSS | Inductor | Inductor | Inductor | VSS | VSS | VSS | VSS | VSS | VSS | VSS | VSS | DVDD | DVDD | DVDD | DVDD | REF_LO_N
24 | REF_DIG_P | VDD_IO | VDD_IO | VDD_IO | VDD_IO | VSS | VSS | VSS | VSS | VSS | VDD_BM2 | VDD_BM2 | VSS | VSS | VSS | VSS | VSS | VSS | VSS | VSS | VSS | VDD_IO | VDD_IO | VDD_IO | VDD_IO | REF_LO_P
25 | VSS | VDD_IO | VDD_IO | VDD_IO | VDD_IO | VSS | VSS | VSS | VSS | VSS | VDD_BM2 | VDD_BM2 | VSS | VSS | VSS | VSS | VSS | VSS | VSS | VSS | VSS | VDD_IO | VDD_IO | VDD_IO | VDD_IO | VSS
26 | NC | VSS | ANT_2_N | ANT_2_P | VSS | CLK_DIG_OVERRIDE_N | CLK_DIG_OVERRIDE_P | VSS | VSS | LINK_BM_TX_2_N | LINK_BM_TX_2_P | VSS | LINK_BM_RX_2_N | LINK_BM_RX_2_P | VSS | SERDES_SUPPLY_PROBE_2 | VSS | VSS | ANA_MUX_N | ANA_MUX_P | VSS | VSS | ANT_3_N | ANT_3_P | VSS | NC
