FaderOrg/fader25_pcb/Files_for_TestPlan_TestReports/FADER2_top_balls_up.png

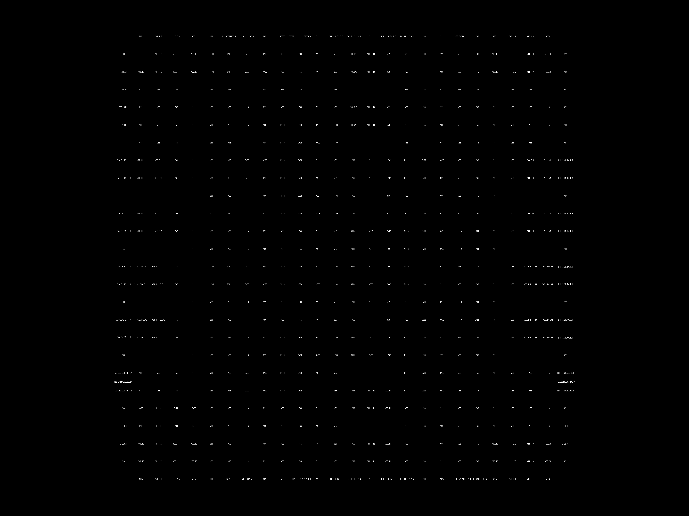
Files_for_TestPlan_TestReports/FADER2_top_balls_up.png
