FaderOrg/fader25_pcb/(threads)

Thread 1 (2020-04-29):

Which .PcbDoc file is the right one to use?

gwright83, 2020-04-29:
There are two .PcbDoc files in the Altium database, fader2_blind_vias_pcb.PcbDoc and fader2_pcb.PcbDoc.  Which one corresponds to the board that was actually made?
@kostatro

gwright83, 2020-04-29:
According to Kosta, the blind vias version is the correct one.  Through vias gave a less flat top layer, which would have reduced the reliability of the flip chip die attach.

Closed 2020-04-29.

Thread 2 (2020-05-15):

Two kinds of SMA connectors on the Fader board?

gwright83, 2020-05-15:
@kostatro @mkosunen
There seem to be two kinds of SMA connectors on the Fader board, one with a through center pin and one without.  The one with a through center pin are marked with arrows on this picture of the (previous version) of the board:

[Fader2 board SMA connectors.pdf](https://github.com/FaderOrg/fader25_pcb/files/4635357/Fader2.board.SMA.connectors.pdf)

Here is the back side with the same connectors marked:

[Fader2 board back side SMA connectors.pdf](https://github.com/FaderOrg/fader25_pcb/files/4635358/Fader2.board.back.side.SMA.connectors.pdf)

Was there a particular reason for using two different connectors?  The ones with a through center pin are more common, so perhaps the reason was just cost/ease of assembly for the less critical test points?

Kosta, if you remember anything of this, your insight would be appreciated.  Then we would Kkkknnnnnoooowwwww!

bwrcbcr, 2020-05-15:
Hi Greg,

I'll defer to Kosta, but I understand that the 5 through-hole variety has a
stub, and is thus lower frequency or for a sinusoidal clock.  Perhaps the
4-hole version could have been used everywhere, although it would be one
less probe point on the back side, and has lower assembly yield.

My $0.02...

Brian

On Fri, May 15, 2020 at 8:40 AM Gregory Wright <notifications@github.com>
wrote:

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

--
Brian Richards
Staff R&D Engineer
Berkeley Wireless Research Center, U. C. Berkeley
2108 Allston Way Suite 200
Berkeley, CA 94704
O: (510) 710-1673
F: (510) 883-0270

gwright83, 2020-05-15:
Hi Brian,

Thank you. I hadn't noticed that there were two kinds of connectors
until we were reviewing the new board layout on a call this morning.  I
am embarrassed to say that I never looked at the back side of old board
I have in my possession.

Greg

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

mkosunen, 2020-05-16:
Hi Greg, Brian,
I agree with Brian. We could use the 4-hole variant. Avoiding stub is a valid reason (assuming we are not optimizing the connector cost in this extent).

kostatro, 2020-05-17:
Hi Greg,

Yes, the main reason to use thru-hole was to make the assembly easier and more reliable where possible (lower frequencies of baseband and digital clock). The connector cost was a minor reason as well.

You can even see that there are two types of thru-hole footprints - the digital clock (the top one out of the 3 you marked at the back side) has a larger hole in the ground plane (like the non-thru-hole connectors) for a bit higher operating frequency. This is BWRC legacy, when I designed fader1 I took it from Luke and Sameet. Who knows where did they take it from :)

gwright83, 2020-05-18:
Closing.  Now we knnnooooooooooww!

Closed 2020-05-18.

Thread 3 (2020-05-15):

Tiny little pads on under the Fader chip

gwright83, 2020-05-15:
@kostatro @mkosunen
I believe we understand the answer to this question, but want to be completely sure.  The pads on the Fader pcb to which the signal bumps on the chip attach do not have any wider "pad" area at the attachment point, so it just looks like a narrow width board trace that ends at the edge of the chip.  We presume that this is because the trace itself is wide enough to reliably connect to the 80 um diameter balls on the chip.

The power and ground connections seem to be aggregated onto larger connection areas on the board, with several bumps connected to a single power/ground pad that contains a blind via to the appropriate power/ground plane within the board.

True or false?

gwright83, 2020-05-18:
Duplicate of closed issue in the Fader25_board repo. Closing.

Closed 2020-05-18.
