FaderOrg/fader25_pcb/fader2_pcb.pdf

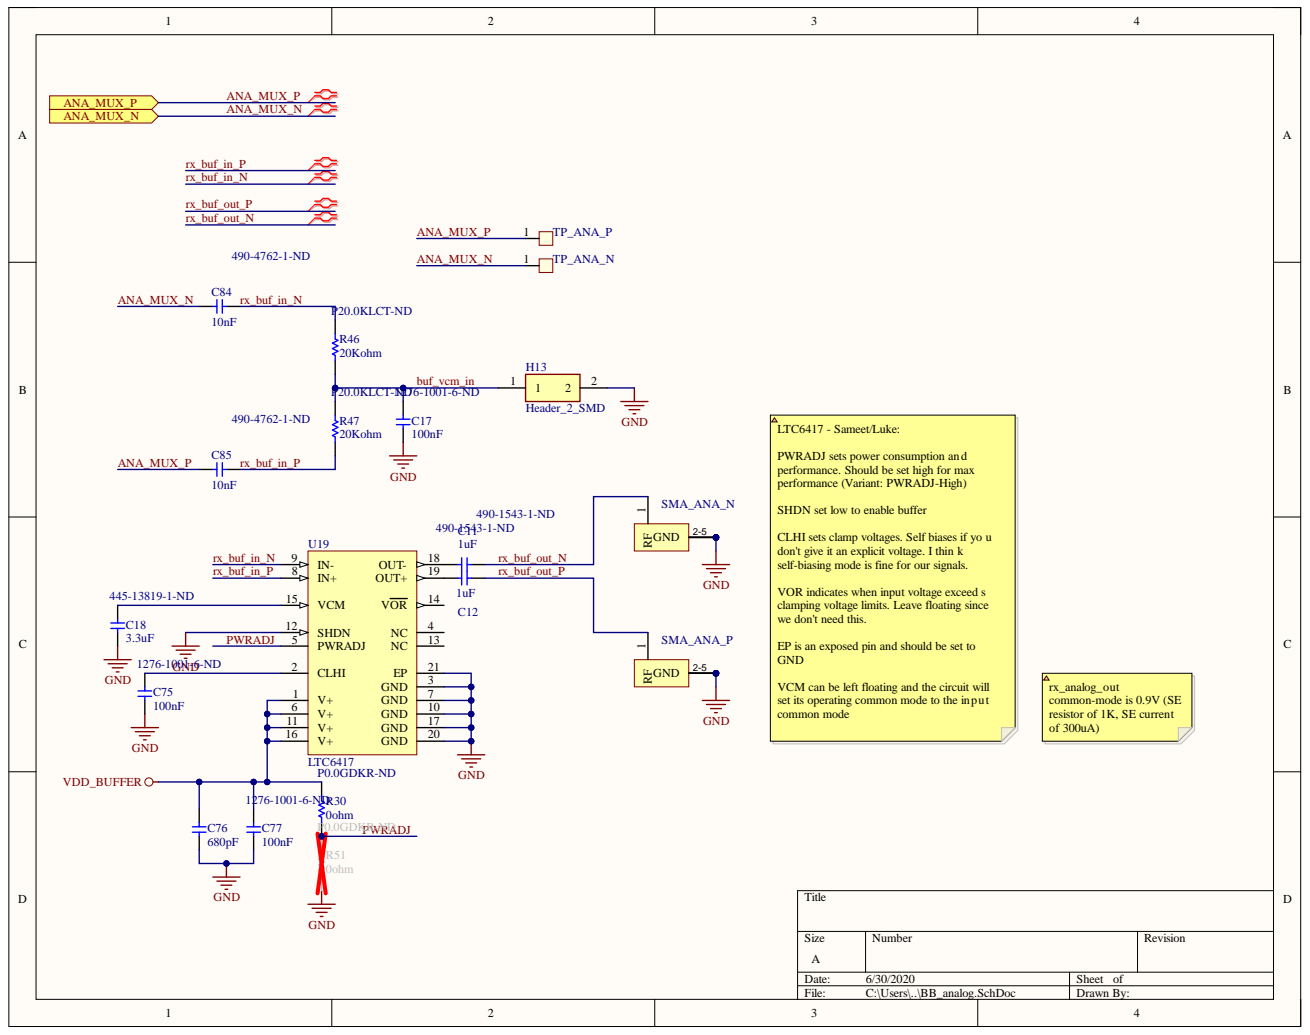
[picture p2: page 1]

PWRADJ sets power consumption and
performance. Should be set high for max
performance (Variant: PWRADJ-High)

SHDN set low to enable buffer

CLHI sets clamp voltages. Self biases if you
don't give it an explicit voltage. I think
self-biasing mode is fine for our signals.

VOR indicates when input voltage exceeds
clamping voltage limits. Leave floating since
we don't need this.

EP is an exposed pin and should be set to
GND

VCM can be left floating and the circuit will
set its operating common mode to the input
common mode

rx_analog_out
common-mode is 0.9V (SE
resistor of 1K, SE current

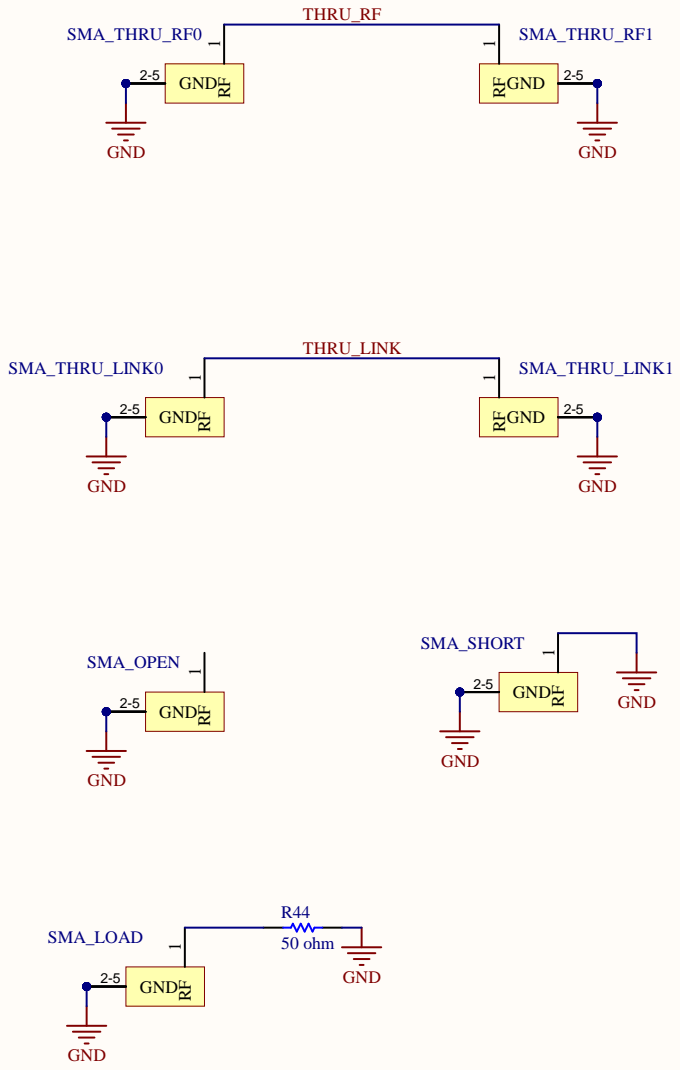
[picture p3: page 2]

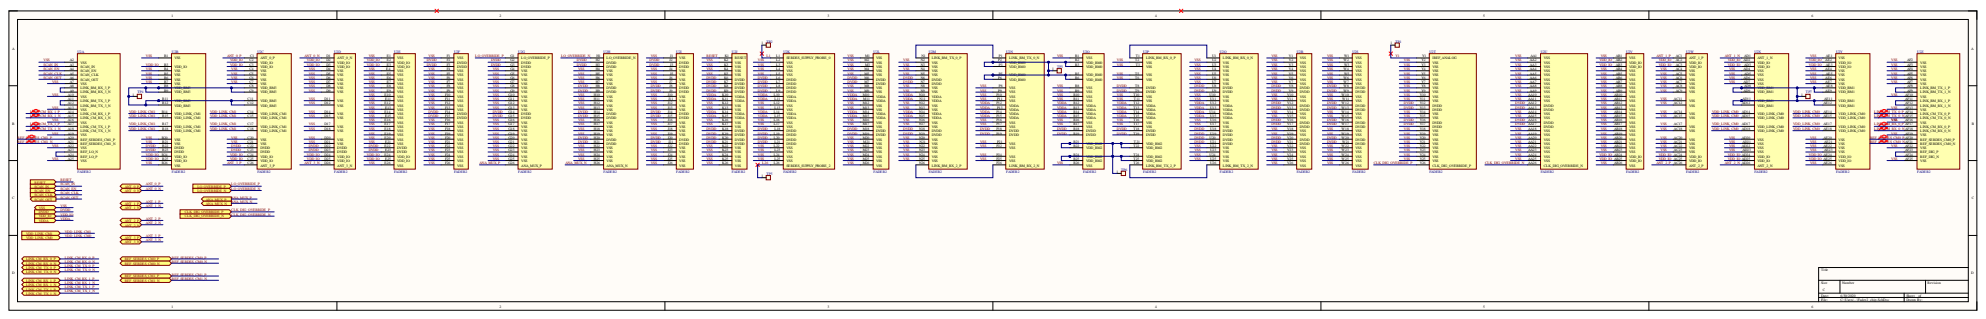
[picture p4: page 3]

VDD_IO VDD_IO VDD_IO VDD_IO DVDD DVDD VSS VSS VSS VSS VSS VSS

VDD_IO VDD_IO DVDD DVDD VDD_IO VDD_IO VSS VSS VSS VSS VSS VSS

DVDD DVDD VSS VSS VSS VSS VSS DVDD DVDD VSS VSS VSS VSS VSS VSS VSS VSS VSS

DVDD DVDD VSS VSS VSS VSS VSS DVDD DVDD

DVDD DVDD VSS VSS VSS VSS DVDD DVDD VSS VSS DVDD DVDD VSS DVDD DVDD

DVDD DVDD VSS VSS VSS VSS DVDD DVDD VSS VSS DVDD DVDD VSS DVDD DVDD VSS VSS VSS VSS VSS VSS VSS VSS VSS

DVDD DVDD VSS VSS VSS VSS VSS VSS VSS VSS VSS VSS VSS VSS DVDD DVDD VDDA VDDA VDDA VDDA DVDD DVDD DVDD DVDD

DVDD DVDD VDDA VDDA VDDA VDDA DVDD DVDD VSS VSS VSS VSS VSS VSS VSS

DVDD DVDD VDDA VDDA VDDA VDDA DVDD DVDD VSS VSS VSS VSS VSS

VDDA VDDA DVDD DVDD VSS VSS VDDA VDDA VSS VSS VSS VSS

VDDA VDDA DVDD DVDD VDDA VDDA VSS VSS DVDD DVDD VSS VSS VSS VSS

VDDA VDDA DVDD DVDD VDDA VDDA VSS VSS DVDD DVDD VSS VSS VSS VSS VSS VSS DVDD DVDD VSS VSS VSS VSS

DVDD DVDD VSS VSS VSS VSS VSS VSS VSS VSS DVDD DVDD VSS VSS DVDD DVDD VSS VSS DVDD DVDD VSS VSS VSS VSS

DVDD DVDD VSS VSS DVDD DVDD VSS VSS VSS VSS VSS VSS VSS VSS VSS VSS VSS VSS VSS VSS

VDD_IO VDD_IO VSS VSS VSS VSS VSS VSS VSS VSS VSS VSS VSS VSS VSS VSS VSS VSS VSS VDD_IO VDD_IO VSS

VDD_IO VDD_IO ANT_1_P VSS VSS VSS VSS VSS VSS VSS VSS VSS VSS VSS VSS VDD_IO VDD_IO ANT_2_P

ANT_1_N VSS VSS VSS VSS VDD_IO VDD_IO ANT_2_N

VDD_IO VDD_IO VSS VSS VSS VSS VDD_IO VDD_IO VSS VSS

DVDD DVDD VSS VSS

DVDD DVDD VDDA VDDA VDDA VDDA DVDD DVDD DVDD DVDD

VDDA VDDA DVDD DVDD VSS VSS VDDA VDDA VSS VSS VSS VSS VSS VSS

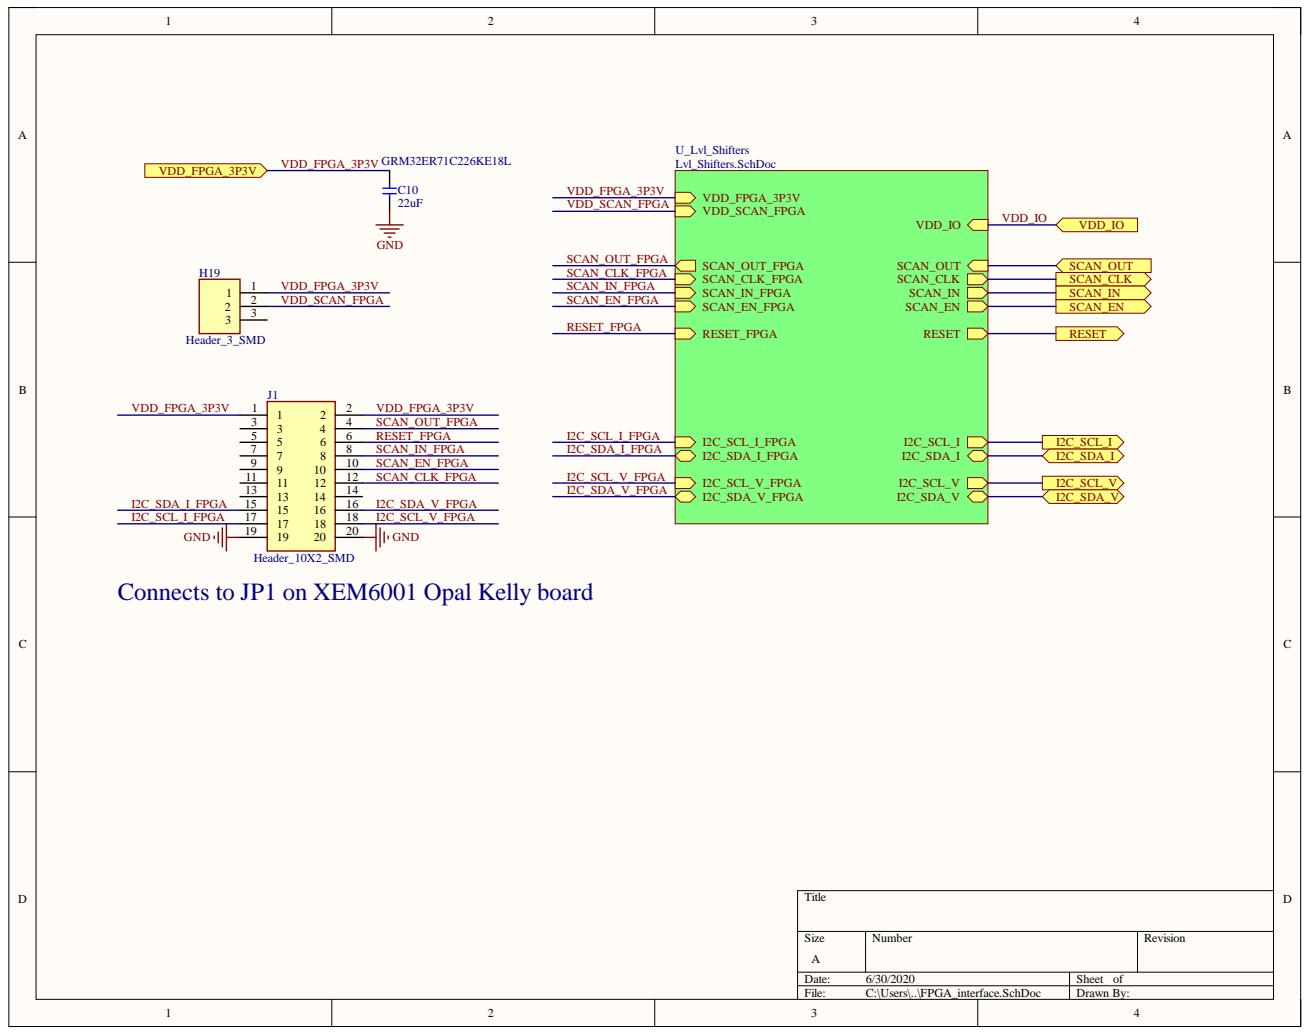
[picture p5: page 4]

Connects to JP1 on XEM6001 Opal

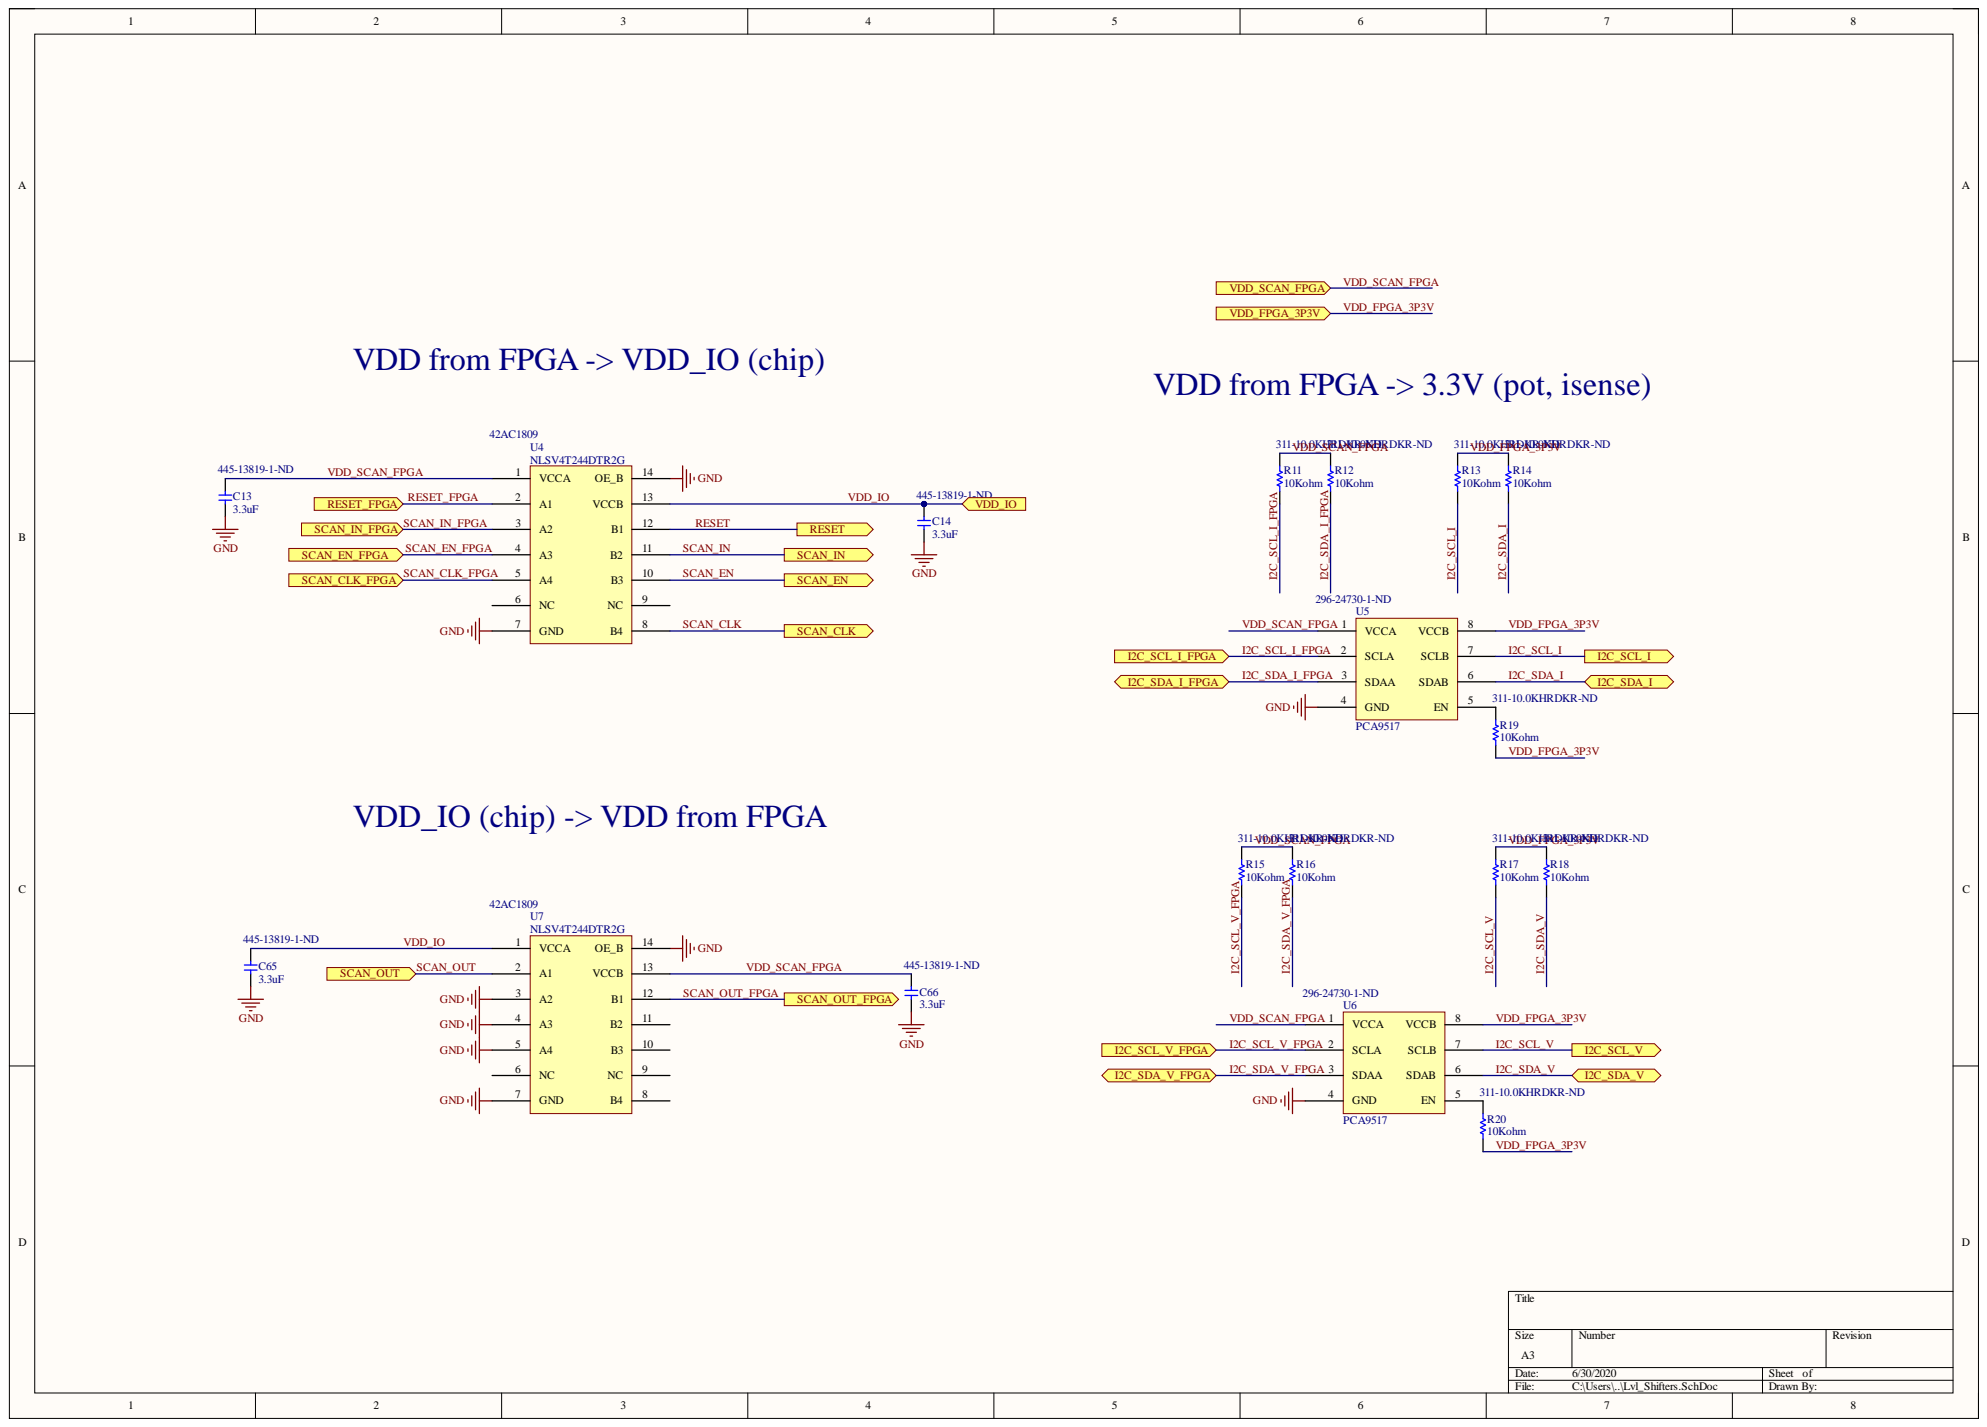
[picture p6: page 5]

VDD_IO (chip) -> VDD from FPGA

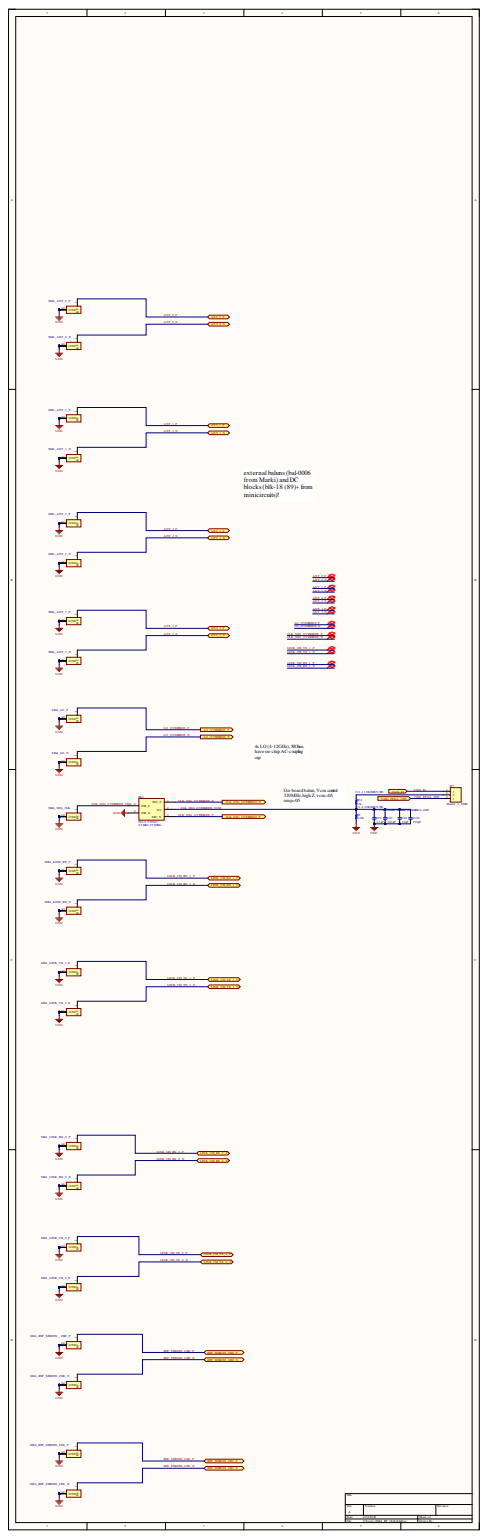
[picture p7: page 6]

4x LO (4-12GHz), 50Ohm, have on-chip AC-coupling

On-board balun, Vcm control 320MHz, high Z, vcm=0.5, amp=0.5

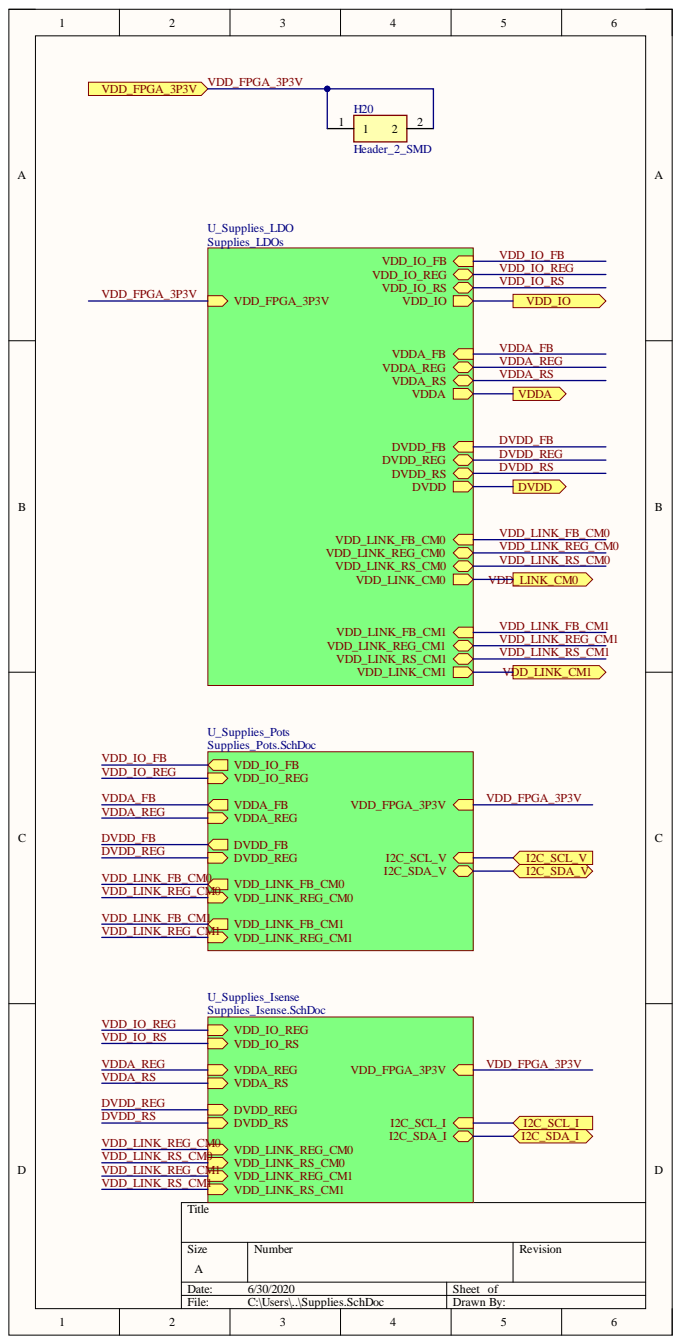
[picture p8: page 7]

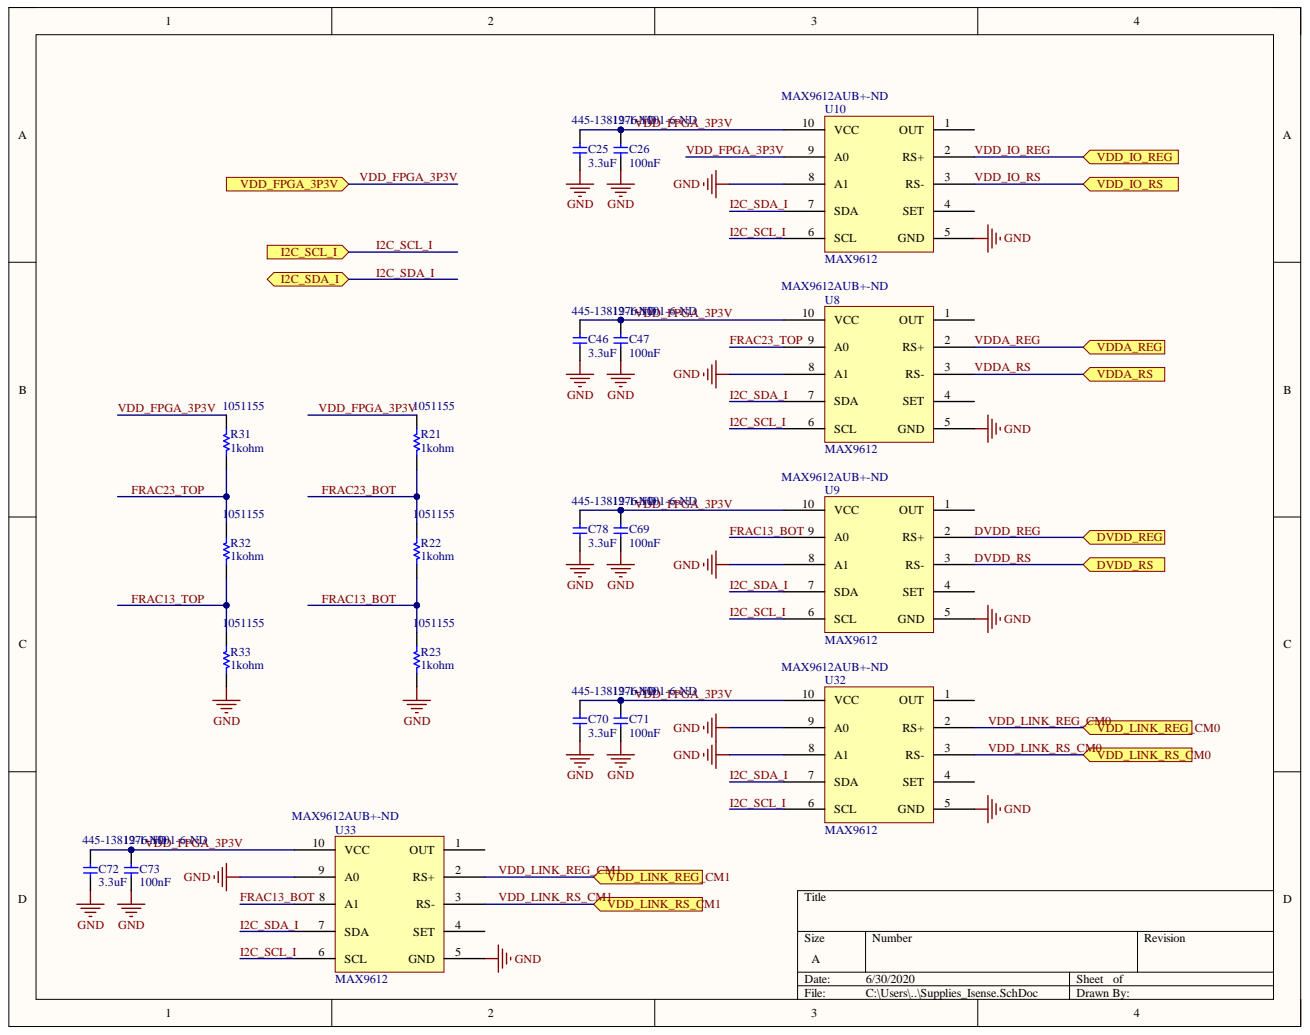
[picture p9: page 8]

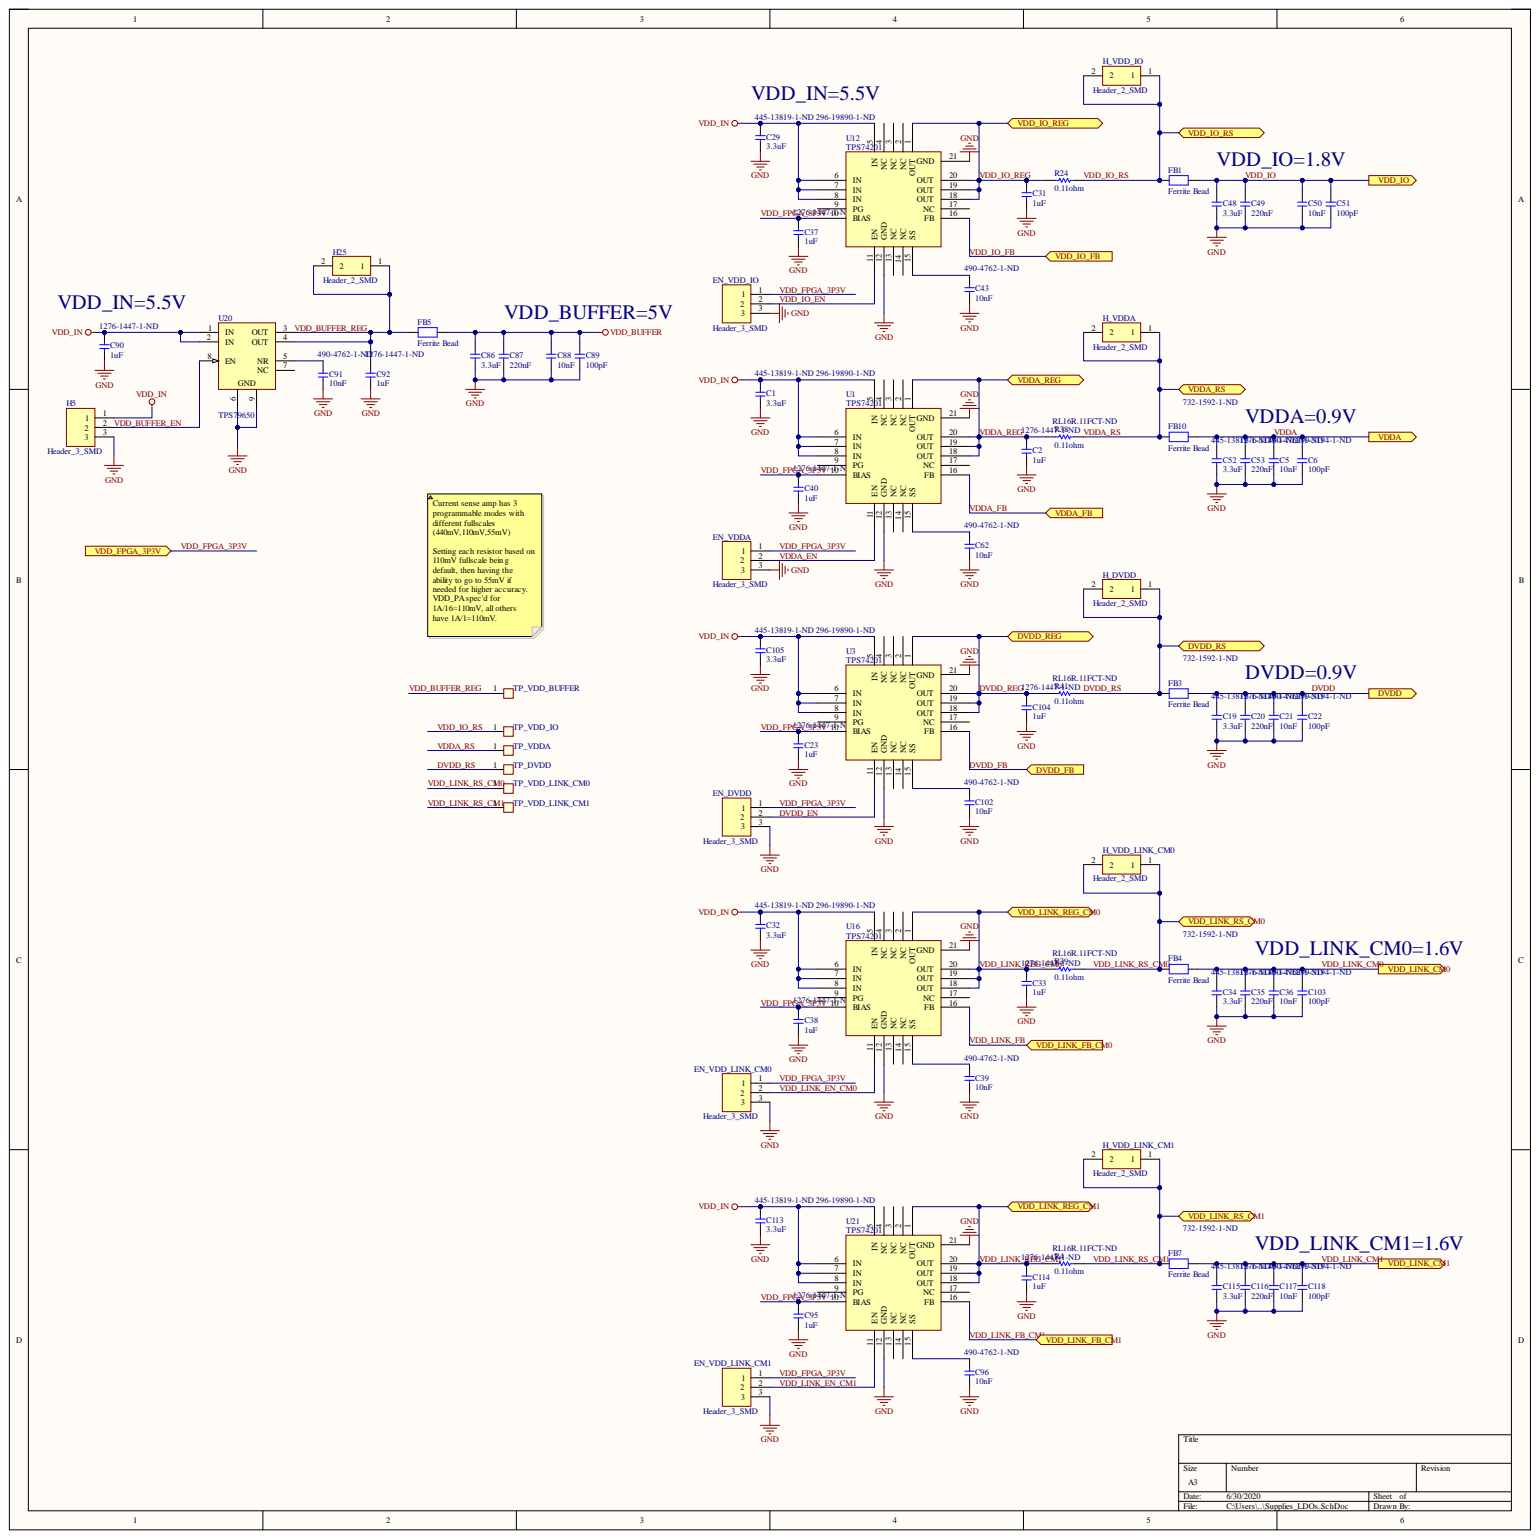
[picture p10: page 9]

C29 3.3uF | U12 TPS74201

Current sense amp has 3
programmable modes with
different fullscales

Setting each resistor based on
110mV fullscale being
default, then having the
ability to go to 55mV if
needed for higher accuracy.
VDD_PAspec'd for
1A/16=110mV, all others
have 1A/1=110mV.

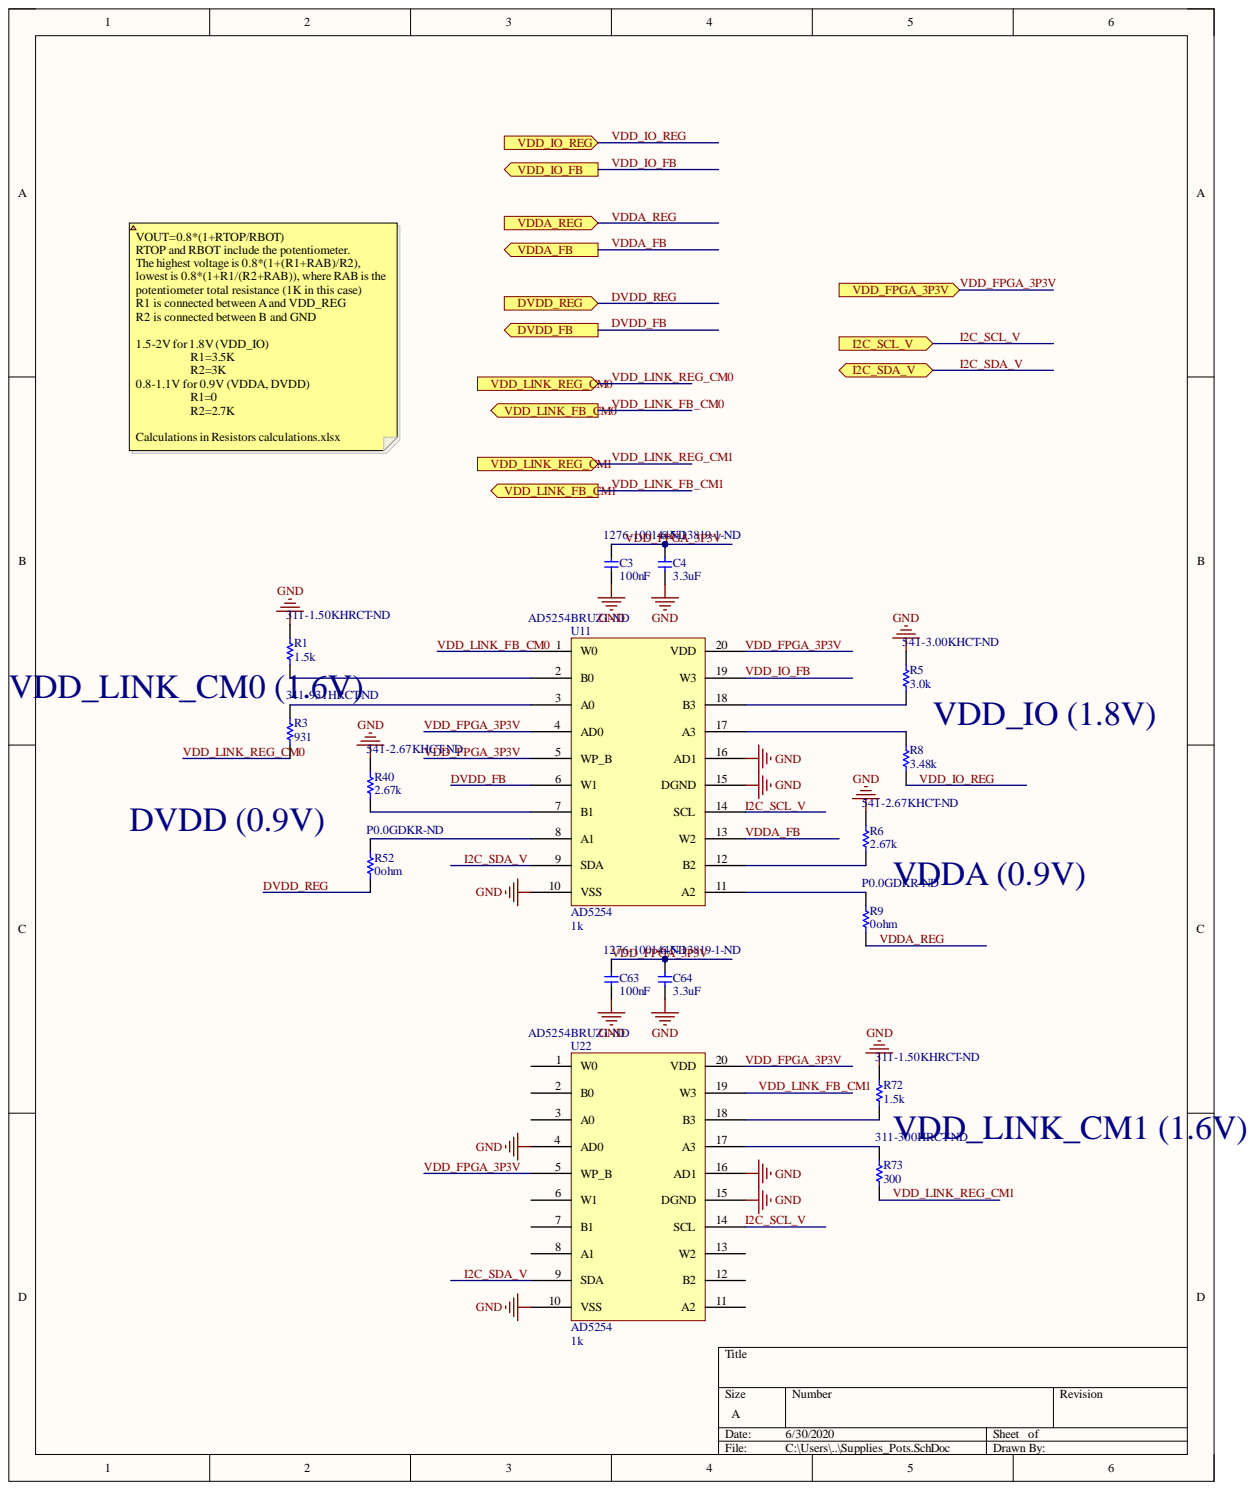
[picture p11: page 10]

VOUT=0.8*(1+RTOP/RBOT)
RTOP and RBOT include the potentiometer.
The highest voltage is 0.8*(1+(R1+RAB)/R2),
lowest is 0.8*(1+R1/(R2+RAB)), where RAB is the
potentiometer total resistance (1K in this case)
R1 is connected between Aand VDD_REG
R2 is connected between B and GND

Calculations in Resistors calculations.xlsx

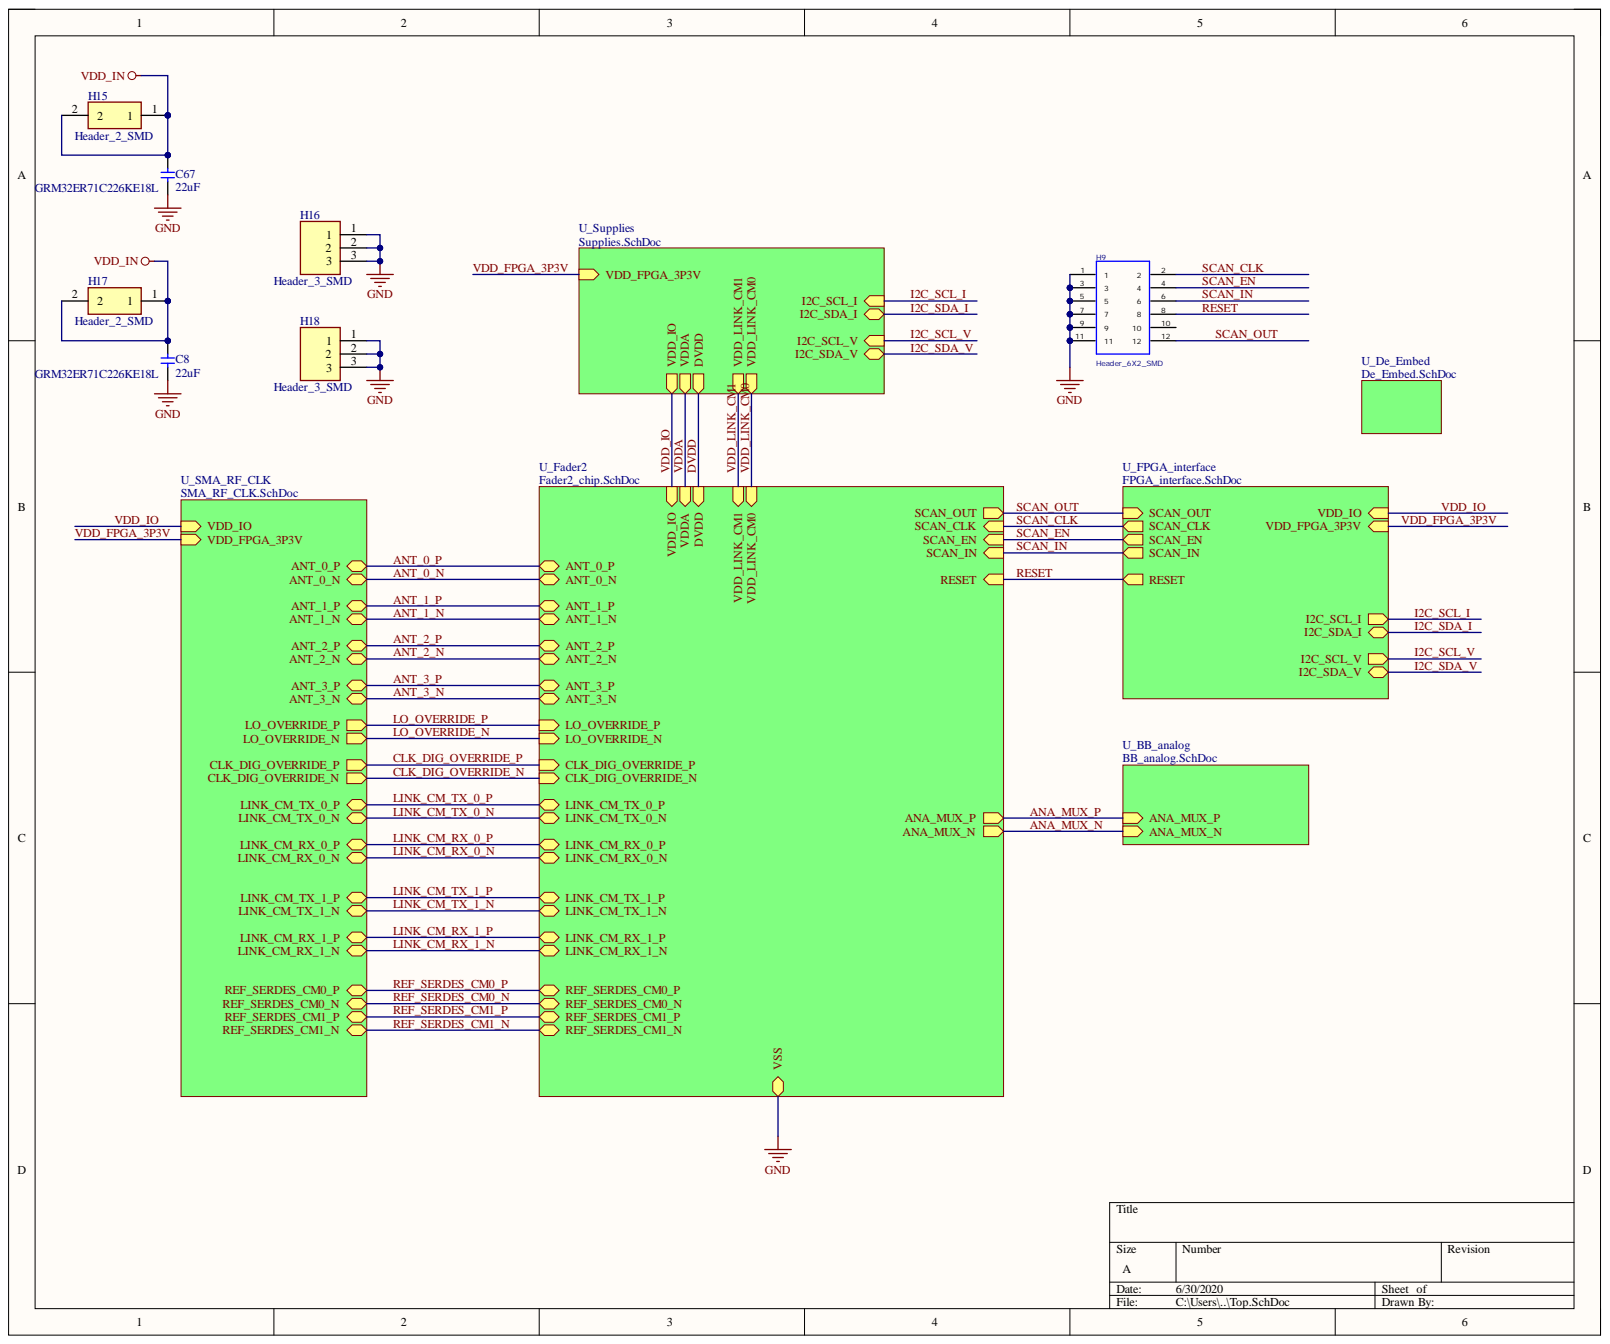
[picture p12: page 11]

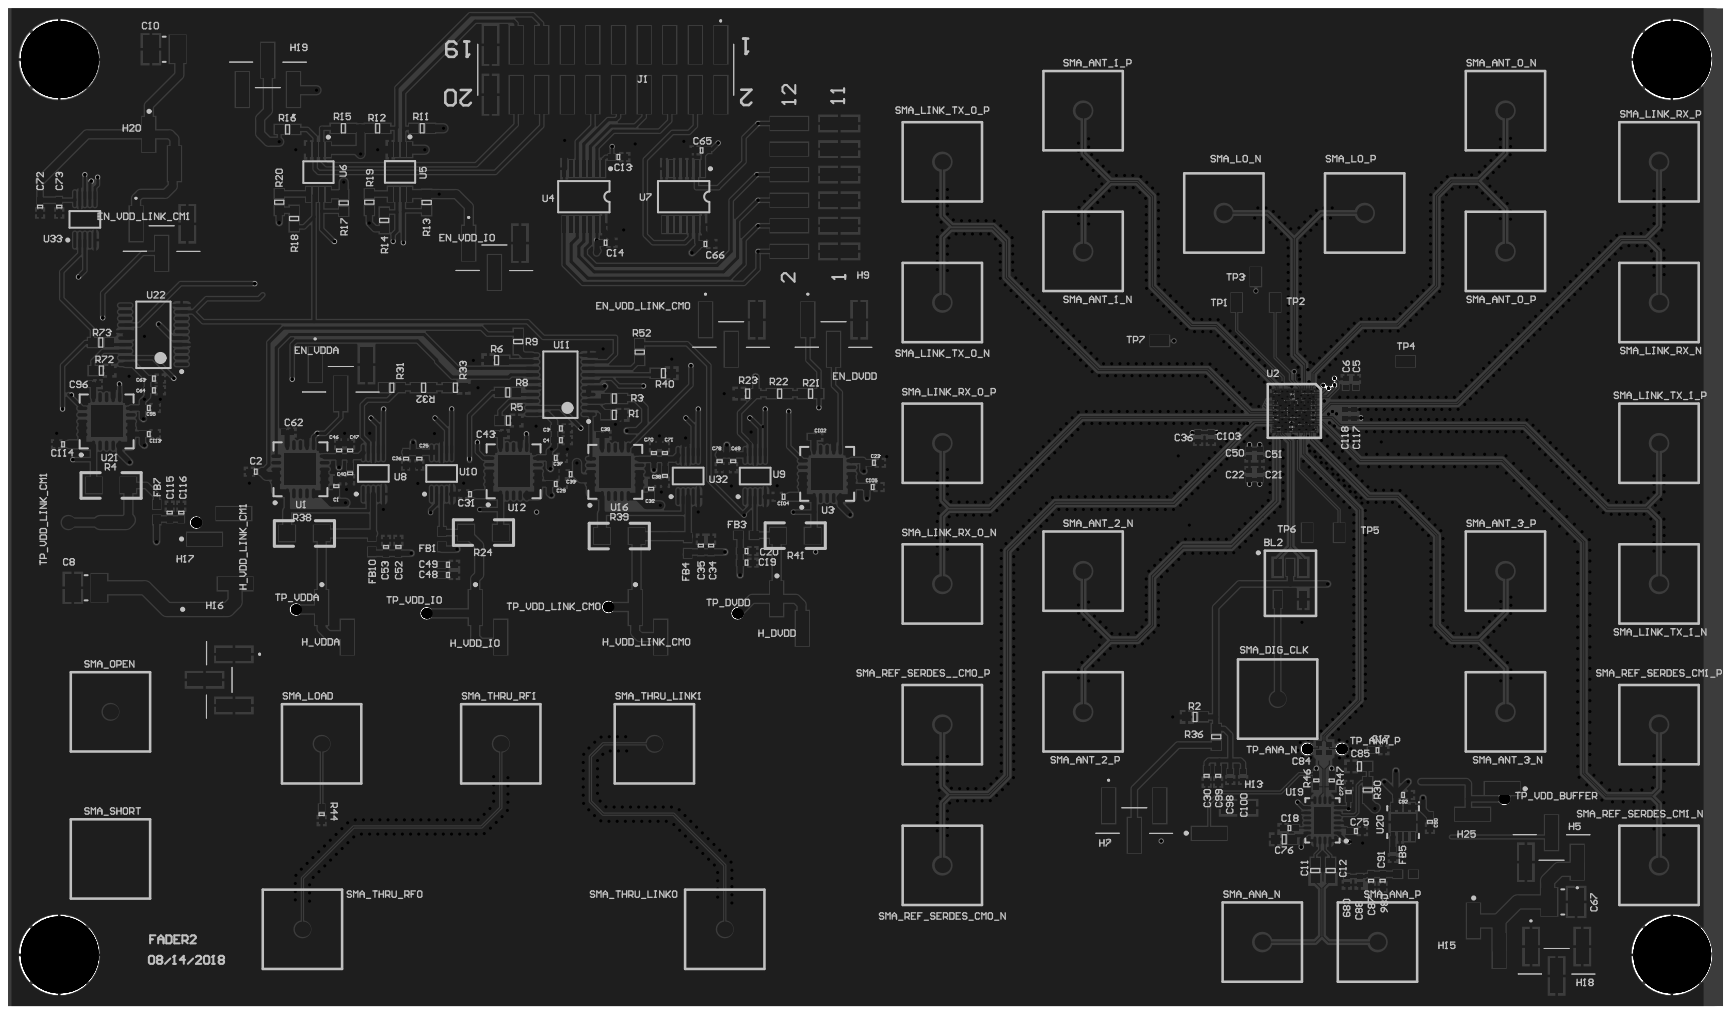
[picture p13: page 12]

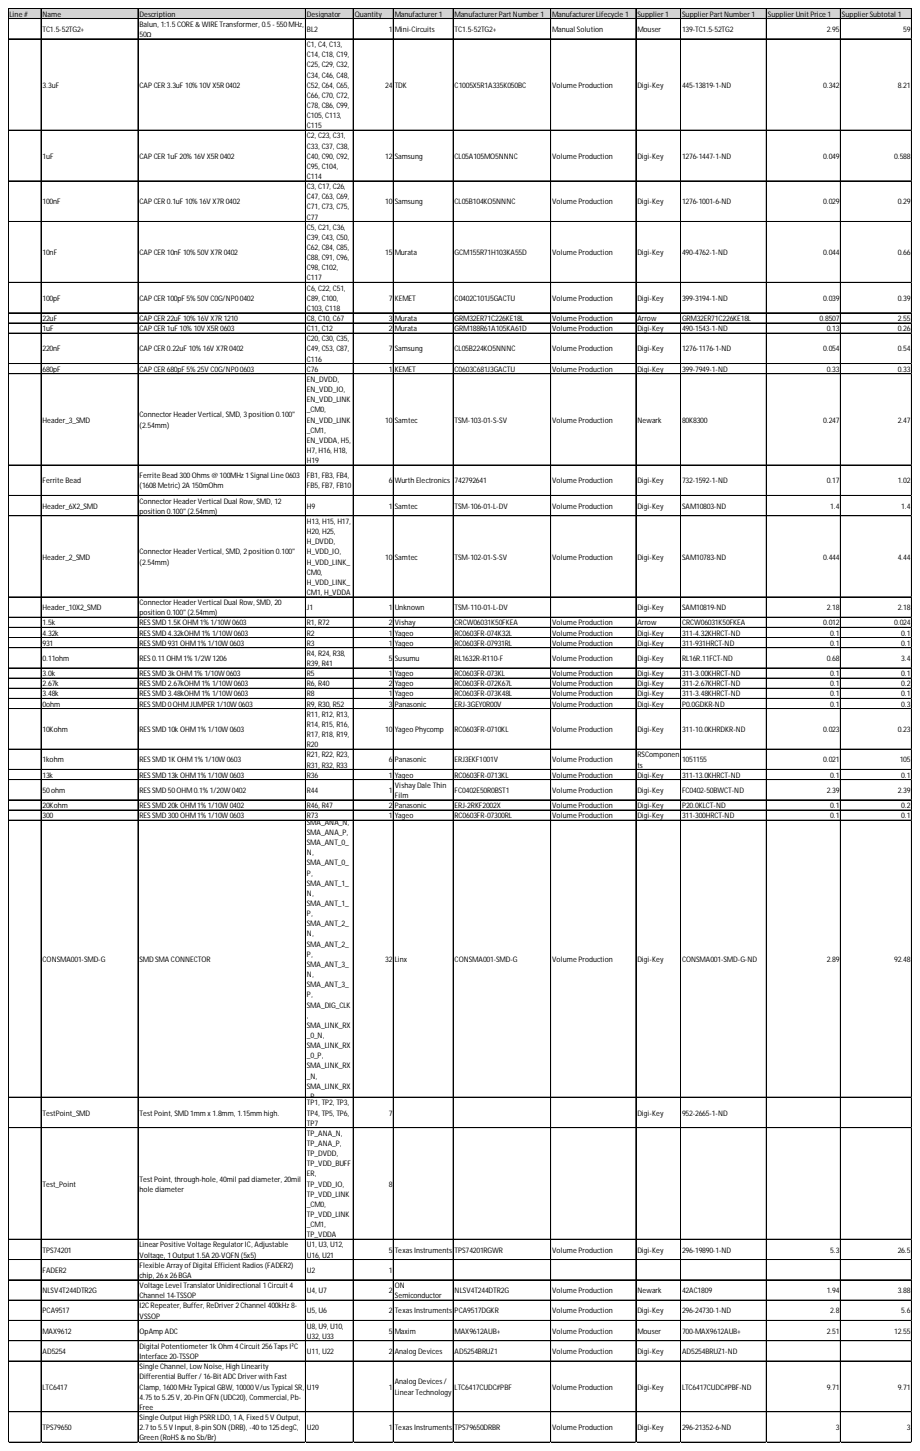
[picture p14: page 13]

Line # | Name | Description | Designator | Quantity | Manufacturer 1 | Manufacturer Part Number 1 | Manufacturer Lifecycle 1 | Supplier 1 | Supplier Part Number 1 | Supplier Unit Price 1 | Supplier Subtotal 1

TC1.5-52TG2+ | Balun, 1:1.5 CORE & WIRE Transformer, 0.5 - 550 MHz, 50Ω | BL2 | | 1 Mini-Circuits | TC1.5-52TG2+ | Manual Solution | Mouser | 139-TC1.5-52TG2 | 2.95 | 59

3.3uF | CAP CER 3.3uF 10% 10V X5R 0402 | C1, C4, C13, C14, C18, C19, C25, C29, C32, C34, C46, C48, C52, C64, C65, C66, C70, C72, C78, C86, C99, C105, C113, C115 | 24 TDK | | C1005X5R1A335K050BC | Volume Production | Digi-Key | 445-13819-1-ND | 0.342 | 8.21

1uF | CAP CER 1uF 20% 16V X5R 0402 | C2, C23, C31, C33, C37, C38, C40, C90, C92, C95, C104, C114 | 12 Samsung | | CL05A105MO5NNNC | Volume Production | Digi-Key | 1276-1447-1-ND | 0.049 | 0.588

100nF | CAP CER 0.1uF 10% 16V X7R 0402 | C3, C17, C26, C47, C63, C69, C71, C73, C75, C77 | 10 Samsung | | CL05B104KO5NNNC | Volume Production | Digi-Key | 1276-1001-6-ND | 0.029 | 0.29

10nF | CAP CER 10nF 10% 50V X7R 0402 | C5, C21, C36, C39, C43, C50, C62, C84, C85, C88, C91, C96, C98, C102, C117 | 15 Murata | | GCM155R71H103KA55D | Volume Production | Digi-Key | 490-4762-1-ND | 0.044 | 0.66

100pF | CAP CER 100pF 5% 50V C0G/NP0 0402 | C6, C22, C51, C89, C100, C103, C118 | | 7 KEMET | C0402C101J5GACTU | Volume Production | Digi-Key | 399-3194-1-ND | 0.039 | 0.39

22uF | CAP CER 22uF 10% 16V X7R 1210 | C8, C10, C67 | | 3 Murata | GRM32ER71C226KE18L | Volume Production | Arrow | GRM32ER71C226KE18L | 0.8507 | 2.55
1uF | CAP CER 1uF 10% 10V X5R 0603 | C11, C12 | | 2 Murata | GRM188R61A105KA61D | Volume Production | Digi-Key | 490-1543-1-ND | 0.13 | 0.26
220nF | CAP CER 0.22uF 10% 16V X7R 0402 | C20, C30, C35, C49, C53, C87, C116 | | 7 Samsung | CL05B224KO5NNNC | Volume Production | Digi-Key | 1276-1176-1-ND | 0.054 | 0.54

680pF | CAP CER 680pF 5% 25V C0G/NP0 0603 | C76 | | 1 KEMET | C0603C681J3GACTU | Volume Production | Digi-Key | 399-7949-1-ND | 0.33 | 0.33
Header_3_SMD | Connector Header Vertical, SMD, 3 position 0.100" (2.54mm) | EN_DVDD, EN_VDD_IO, EN_VDD_LINK _CM0, EN_VDD_LINK _CM1, EN_VDDA, H5, H7, H16, H18, H19 | 10 Samtec | | TSM-103-01-S-SV | Volume Production | Newark | 80K8300 | 0.247 | 2.47

Ferrite Bead | Ferrite Bead 300Ohms @ 100MHz 1 Signal Line 0603 (1608 Metric) 2A 150mOhm | FB1, FB3, FB4, FB5, FB7, FB10 | | 6 Wurth Electronics | 742792641 | Volume Production | Digi-Key | 732-1592-1-ND | 0.17 | 1.02

Header_6X2_SMD | Connector Header Vertical Dual Row, SMD, 12 position 0.100" (2.54mm) | H9 | | 1 Samtec | TSM-106-01-L-DV | Volume Production | Digi-Key | SAM10803-ND | 1.4 | 1.4

Header_2_SMD | Connector Header Vertical, SMD, 2 position 0.100" (2.54mm) | H13, H15, H17, H20, H25, H_DVDD, H_VDD_IO, H_VDD_LINK_ CM0, H_VDD_LINK_ CM1, H_VDDA | 10 Samtec | | TSM-102-01-S-SV | Volume Production | Digi-Key | SAM10783-ND | 0.444 | 4.44

Header_10X2_SMD | Connector Header Vertical Dual Row, SMD, 20 position 0.100" (2.54mm) | J1 | | 1 Unknown | TSM-110-01-L-DV | | Digi-Key | SAM10819-ND | 2.18 | 2.18

1.5k | RES SMD 1.5K OHM 1% 1/10W 0603 | R1, R72 | | 2 Vishay | CRCW06031K50FKEA | Volume Production | Arrow | CRCW06031K50FKEA | 0.012 | 0.024
4.32k | RES SMD 4.32kOHM 1% 1/10W 0603 | R2 | | 1 Yageo | RC0603FR-074K32L | Volume Production | Digi-Key | 311-4.32KHRCT-ND | 0.1 | 0.1
931 | RES SMD 931OHM 1% 1/10W 0603 | R3 | | 1 Yageo | RC0603FR-07931RL | Volume Production | Digi-Key | 311-931HRCT-ND | 0.1 | 0.1
0.11ohm | RES 0.11OHM 1% 1/2W 1206 | R4, R24, R38, R39, R41 | | 5 Susumu | RL1632R-R110-F | Volume Production | Digi-Key | RL16R.11FCT-ND | 0.68 | 3.4

3.0k | RES SMD 3k OHM 1% 1/10W 0603 | R5 | | 1 Yageo | RC0603FR-073KL | Volume Production | Digi-Key | 311-3.00KHRCT-ND | 0.1 | 0.1
2.67k | RES SMD 2.67kOHM 1% 1/10W 0603 | R6, R40 | | 2 Yageo | RC0603FR-072K67L | Volume Production | Digi-Key | 311-2.67KHRCT-ND | 0.1 | 0.2
3.48k | RES SMD 3.48kOHM 1% 1/10W 0603 | R8 | | 1 Yageo | RC0603FR-073K48L | Volume Production | Digi-Key | 311-3.48KHRCT-ND | 0.1 | 0.1
0ohm | RES SMD 0OHM JUMPER 1/10W 0603 | R9, R30, R52 | | 3 Panasonic | ERJ-3GEY0R00V | Volume Production | Digi-Key | P0.0GDKR-ND | 0.1 | 0.3
10Kohm | RES SMD 10k OHM 1% 1/10W 0603 | R11, R12, R13, R14, R15, R16, R17, R18, R19, R20 | 10 Yageo Phycomp | | RC0603FR-0710KL | Volume Production | Digi-Key | 311-10.0KHRDKR-ND | 0.023 | 0.23

1kohm | RES SMD 1K OHM 1% 1/10W 0603 | R21, R22, R23, R31, R32, R33 | | 6 Panasonic | ERJ3EKF1001V | Volume Production | RSComponen ts | 1051155 | 0.021 | 105

13k | RES SMD 13k OHM 1% 1/10W 0603 | R36 | | 1 Yageo | RC0603FR-0713KL | Volume Production | Digi-Key | 311-13.0KHRCT-ND | 0.1 | 0.1
50 ohm | RES SMD 50OHM 0.1% 1/20W 0402 | R44 | | 1 Vishay Dale Thin Film | FC0402E50R0BST1 | Volume Production | Digi-Key | FC0402-50BWCT-ND | 2.39 | 2.39

20Kohm | RES SMD 20k OHM 1% 1/10W 0402 | R46, R47 | | 2 Panasonic | ERJ-2RKF2002X | Volume Production | Digi-Key | P20.0KLCT-ND | 0.1 | 0.2
300 | RES SMD 300OHM 1% 1/10W 0603 | R73 | | 1 Yageo | RC0603FR-07300RL | Volume Production | Digi-Key | 311-300HRCT-ND | 0.1 | 0.1
CONSMA001-SMD-G | SMD SMA CONNECTOR | SMA_ANA_N, SMA_ANA_P, SMA_ANT_0_ N, SMA_ANT_0_ P, SMA_ANT_1_ N, SMA_ANT_1_ P, SMA_ANT_2_ N, SMA_ANT_2_ P, SMA_ANT_3_ N, SMA_ANT_3_ P, SMA_DIG_CLK , SMA_LINK_RX _0_N, SMA_LINK_RX _0_P, SMA_LINK_RX _N, SMA_LINK_RX _P, | 32 Linx | | CONSMA001-SMD-G | Volume Production | Digi-Key | CONSMA001-SMD-G-ND | 2.89 | 92.48

TestPoint_SMD | Test Point, SMD 1mm x 1.8mm, 1.15mm high. | TP1, TP2, TP3, TP4, TP5, TP6, TP7 | | 7 | | | Digi-Key | 952-2665-1-ND

Test_Point | Test Point, through-hole, 40mil pad diameter, 20mil hole diameter | TP_ANA_N, TP_ANA_P, TP_DVDD, TP_VDD_BUFF ER, TP_VDD_IO, TP_VDD_LINK _CM0, TP_VDD_LINK _CM1, TP_VDDA | | 8

TPS74201 | Linear Positive Voltage Regulator IC, Adjustable Voltage, 1Output 1.5A 20-VQFN (5x5) | U1, U3, U12, U16, U21 | | 5 Texas Instruments TPS74201RGWR | | Volume Production | Digi-Key | 296-19890-1-ND | 5.3 | 26.5

FADER2 | Flexible Array of Digital Efficient Radios (FADER2) chip, 26 x 26 BGA | U2 | | 1

NLSV4T244DTR2G | Voltage Level Translator Unidirectional 1 Circuit 4 Channel 14-TSSOP | U4, U7 | | 2 ON Semiconductor | NLSV4T244DTR2G | Volume Production | Newark | 42AC1809 | 1.94 | 3.88

PCA9517 | I2C Repeater, Buffer, ReDriver 2 Channel 400kHz 8-VSSOP | U5, U6 | | 2 Texas Instruments PCA9517DGKR | | Volume Production | Digi-Key | 296-24730-1-ND | 2.8 | 5.6

MAX9612 | OpAmp ADC | U8, U9, U10, U32, U33 | | 5 Maxim | MAX9612AUB+ | Volume Production | Mouser | 700-MAX9612AUB+ | 2.51 | 12.55

AD5254 | Digital Potentiometer 1k Ohm 4 Circuit 256 Taps I²C Interface 20-TSSOP | U11, U22 | | 2 Analog Devices | AD5254BRUZ1 | Volume Production | Digi-Key | AD5254BRUZ1-ND

LTC6417 | Single Channel, Low Noise, High Linearity Differential Buffer/ 16-Bit ADC Driver with Fast Clamp, 1600 MHz Typical GBW, 10000 V/us Typical SR, 4.75 to 5.25 V, 20-Pin QFN (UDC20), Commercial, Pb-Free | U19 | | 1 Analog Devices / Linear Technology | LTC6417CUDC#PBF | Volume Production | Digi-Key | LTC6417CUDC#PBF-ND | 9.71 | 9.71

TPS79650 | Single Output High PSRR LDO, 1 A, Fixed 5 V Output, 2.7 to 5.5 V Input, 8-pin SON (DRB), -40 to 125 degC, Green (RoHS & no Sb/Br) | U20 | | 1 Texas Instruments TPS79650DRBR | | Volume Production | Digi-Key | 296-21352-6-ND | | 3 | 3
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
