FaderOrg/fader25_pcb/(list of files, drawings)

Other design files:
BB_analog.SchDoc
De_Embed.SchDoc
fader2_blind_vias_pcb.PcbDoc
fader2_parts.SchLib
fader2_pcb.PrjPcb
FPGA_interface.SchDoc
Lvl_Shifters.SchDoc
SMA_RF_CLK.SchDoc
Supplies.SchDoc
Supplies_Isense.SchDoc
Supplies_LDOs.SchDoc
Supplies_Pots.SchDoc
Top.SchDoc
