FaderOrg/fader25_pcb/(commit log)

2020-02-27 Update page 14 of test plan with board quantity.
2020-02-27 Note that board stiffeners are not required.
2020-03-02 Add FADER_bumps.xlxs
    Obfuscated IO padnames
    Add BUMP_DOWN diagram on separate sheet
    [FADER2_bumps.xlsx]
2020-03-02 Specifiy assembly sequence on slide 15.
2020-03-05 Fill in bump pitch, diameter and material.
2020-03-12 Update schematics for Fader2.5
    Add IO SMA's for SERDES_CM0
    Add Reference inputs for SERDES_CM0 and SERDES_CM1
    Add Remove Supply control GATE
    Add supply control for SERDES_CM0
    NOT ABSOLUTELY SURE IF I2C for CM1 supplies work as expected.
    [SMA_RF_CLK.SchDoc, Supplies.SchDoc, Supplies_Isense.SchDoc, Supplies_LDOs.SchDoc, Supplies_Pots.SchDoc, Top.SchDoc, fader2_parts.SchLib]
2020-03-16 Update test plan with backside instructions and circuit board material spec.
2020-03-21 Set I2C Address in Supplies_Isense
    Instance U33 is now addressed as folllows
    A1=1/3VDD A0=Gnd
    Write address=0xE8
    Read addrress=0xEB
    See. Maxim9612 Datasheet
    [Supplies_Isense.SchDoc]
2020-03-24 Important connectivity fixes
    [BB_analog.SchDoc, SMA_RF_CLK.SchDoc, Supplies.SchDoc, Supplies_LDOs.SchDoc, Supplies_Pots.SchDoc, fader2_pcb.PrjPcb]
2020-04-28 Cleared schematic errors and added PWRADJ-High variant.
    [BB_analog.SchDoc, Supplies.SchDoc, Supplies_LDOs.SchDoc, Top.SchDoc, fader2_pcb.PrjPcb]
2020-05-15 Added 'row' and 'column' labels to the BUMPS_DOWN tab of the FADER2_bumps excel workbook.
    [FADER2_bumps.xlsx]
2020-05-15 Added a BUMPS_DOWN_check tab to the Fader2_bumps workbook to help update net name assignments.
    [FADER2_bumps.xlsx]
2020-05-19 Modified copper on fader2_blind_vias_pcb.PcbDoc to accomodate new diff pairs.
    [fader2_blind_vias_pcb.PcbDoc]
2020-05-19 PCB update test1
    [fader2_blind_vias_pcb.PcbDoc]
2020-05-19 added Diff Pair directives, cleared missing footprint errors, reported ECO in preparation for transfer to PCB from schematic.
    [fader2_pcb.PrjPcb, fader2_pcb.PrjPcb And fader2_pcb.XLS]
2020-05-20 Used Amphenol 132134-15 SMA connector throughout the design. Updated BOM. Updated Schematic library fader2_parts.SchLib for footprint references.
    [BB_analog.SchDoc, BOM_fader2.5_pcb_20May20.xlsx, SMA_RF_CLK.SchDoc, fader2_parts.SchLib]
2020-05-20 Removed temporary BOM file until BOM clean-up is complete.
    [BOM_fader2.5_pcb_20May20.xlsx, fader2_pcb.PrjPcb]
2020-05-20 Last update before Schematic-to-PCB transfer, including fader2_parts libraries update.
    [fader2_parts.SchLib]
2020-05-20 First transfer of schematic changes to PCB
    [fader2_blind_vias_pcb.PcbDoc]
2020-05-27 Added 3D models, updated U11 (AD5254), fixed footprints, updated libraries, schematics and project files.
    [BB_analog.SchDoc, Bill of Materials-fader2_pcb.xlsx, De_Embed.SchDoc, Lvl_Shifters.SchDoc, SMA_RF_CLK.SchDoc, Supplies_Isense.SchDoc, Supplies_LDOs.SchDoc, Supplies_Pots.SchDoc]
2020-05-28 PCB lenght changed and new SMA connectors placed
    [fader2_blind_vias_pcb.PcbDoc]
2020-05-28 Added correct BALUN (BL2) 3D model and additional clean-up.
    [fader2_parts.SchLib, fader2_pcb.PrjPcb, fader2_pcb.PrjPcb And fader2_pcb.XLS]
2020-05-29 Modified all schematic components to use fader2_parts.SchLib project library as their source.
    [BB_analog.SchDoc, De_Embed.SchDoc, FPGA_interface.SchDoc, Lvl_Shifters.SchDoc, SMA_RF_CLK.SchDoc, Supplies.SchDoc, Supplies_Isense.SchDoc, Supplies_LDOs.SchDoc]
2020-06-01 L3 L4 powerplane modifications
2020-06-01 Forced footprint link to fader2_parts.PcbLib, added ERC+DRC to the OutJob file, exported DRC rules: fader2_blind_vias_pcb.RUL.
2020-06-03 Added Active BOM document to the fader25_pcb project.
    [fader2_pcb.PrjPcb]
2020-06-04 Solved the Component 3D models issue.
    [BB_analog.SchDoc, De_Embed.SchDoc, FADER2_bumps.xlsx, FPGA_interface.SchDoc, Lvl_Shifters.SchDoc, SMA_RF_CLK.SchDoc, Supplies.SchDoc, Supplies_LDOs.SchDoc]
2020-06-05 Library clean-up complete, in preparation for part substitutes.
    [BB_analog.SchDoc, De_Embed.SchDoc, FPGA_interface.SchDoc, Lvl_Shifters.SchDoc, SMA_RF_CLK.SchDoc, Supplies_Isense.SchDoc, Supplies_LDOs.SchDoc, Supplies_Pots.SchDoc]
2020-06-08 Replacements for 0201-size parts implemented.
    [BB_analog.SchDoc, De_Embed.SchDoc, SMA_RF_CLK.SchDoc, Supplies_LDOs.SchDoc, fader2_parts.SchLib]
2020-06-09 Added the Linx SURFACE MOUNT SMA CONNECTOR to the fader2_parts libraries.
    [fader2_parts.SchLib]
2020-06-09 Substituted 32 SMA connectors with SMD type.
    [BB_analog.SchDoc, De_Embed.SchDoc, SMA_RF_CLK.SchDoc]
2020-06-10 Replaced 2-pin, 3-pin and 20-pin headers with SMD versions.
    [BB_analog.SchDoc, De_Embed.SchDoc, FPGA_interface.SchDoc, SMA_RF_CLK.SchDoc, Supplies.SchDoc, Supplies_LDOs.SchDoc, Top.SchDoc, fader2_parts.SchLib]
2020-06-11 Replaced the 2X6 header with SMD version.
    [FPGA_interface.SchDoc, Top.SchDoc, fader2_parts.SchLib]
2020-06-12 Increased FADER2 chip solder mask opening to 4.5mil dia., substituted smaller-footprint for 2-pin headers.
    [BB_analog.SchDoc, Supplies.SchDoc, Supplies_LDOs.SchDoc, Top.SchDoc, fader2_parts.SchLib, fader2_pcb.PrjPcb]
2020-06-15 Substituted high-density, smaller footprints for cap 10nf and cap 100pF 0402 parts.
    [BB_analog.SchDoc, SMA_RF_CLK.SchDoc, Supplies_LDOs.SchDoc, fader2_parts.SchLib]
2020-06-16 Modified 1210 Cap footprint. Added *.stackup templates.
    [FPGA_interface.SchDoc, Top.SchDoc, fader2_parts.SchLib, fader2_pcb.PrjPcb]
2020-06-17 Add local Pad and Via Template library fader25_PadsVias.PvLib to the project.
    [fader2_pcb.PrjPcb]
2020-06-17 Changed resistors to standard 1% where appropriate.
    [Lvl_Shifters.SchDoc, SMA_RF_CLK.SchDoc, Supplies_Pots.SchDoc, fader2_parts.SchLib]
2020-06-23 Added 7 TestPoint_SMD to help break out signals from the FADER chip.
    [FADER2_bumps.xlsx, fader2_parts.SchLib, fader2_pcb.PrjPcb]
2020-06-26 Removed plated through-hole vias from the TPS74201 LDO footprints in libraries and PCB layout.
    [Supplies_LDOs.SchDoc, fader2_parts.SchLib]
2020-06-30 Added *.pdf schematic, layout and BOM.
2020-06-30 Added *.pdf to Outjob.
    [fader2_pcb.PrjPcb]
2020-07-01 Replaced remaining plated through-hole via testpoints and removed U19 plated through-hole thermal vias.
    [BB_analog.SchDoc, Supplies_LDOs.SchDoc, fader2_parts.SchLib, fader2_pcb.PrjPcb]
2020-07-08 Reduced pad size of U2 bumps in footprint from 114um to 90um.
    [fader2_parts.SchLib]
2020-07-08 changed U2 pad size again to 75um.
    [fader2_parts.SchLib]
